Jana-Elst/passionProject/blog/src/content/blog/20251212-1-concept.md

---
title: '#2 Concept'
description: 'Let two strangers talk for just two minutes.'
pubDate: 'Jan 4 2026'
heroImage: '../../assets/notes/20260104-concept1.png'
links: 
    - { title: 'Passion Project Research', url: 'https://www.figma.com/board/GRPQDEXH0DziOyojPpeU3K/Passion-project?node-id=0-1&t=wNoFfJWDigMh43Gp-1' }
    - { title: 'Concept Pitch', url: 'https://www.figma.com/slides/nmPEOl1ZZNPz9g4mxP1xrw/Pitch-passion-project?node-id=1-42&t=YsAiy9dJiDsgLmYT-1' }
---
From my research question: *'How might we use obsolete technologies to break the smartphone bubble and facilitate meaningful micro-interactions between strangers?'*, I created a concept called: *[DIS]CONNECT*.

I want to build an installation for an exhibition or a museum, so the target audience will be broad: from young digital natives to older generations who remember a time before the screen.

My goal for the project is really simple: *'let two strangers talk for just two minutes.'*

## Storyboard
So, what will this look like? I will create an installation split into two different spaces within the exhibition.

In Room A, we have 'The Switchboard'. It will refer to the vintage manual telephone exchange. The kind with cables and plugs. The user here is the Operator. They see jacks labeled not with names, but with themes. To start, the Operator physically plugs the cable of the telephone into the topic of their choice.

At that exact moment, in Room B, a lonely, old-fashioned telephone starts to ring. A random visitor, the Receiver, hears it. Hopefully, curiosity takes over, and they pick up.

And a warm voice-over connects them. It tells the Operator: ‘Ooh, you chose a nice question, I'll let the phone ring on the other end of the line, please wait a moment.’ It tells the Receiver: ‘Thanks for picking up! There's someone on the other end of the line waiting for you.' And for both, the voice-over will state the chosen question.

For the next two minutes, two strangers share a small, unrecorded moment. If there is a long silence, or the time is up, the Voice Over gently intervenes to end the call.

<div class="note">
I will switch from the switchboard to the rotary dial of the telephone. By doing this, the interaction will be more user-friendly.
</div>

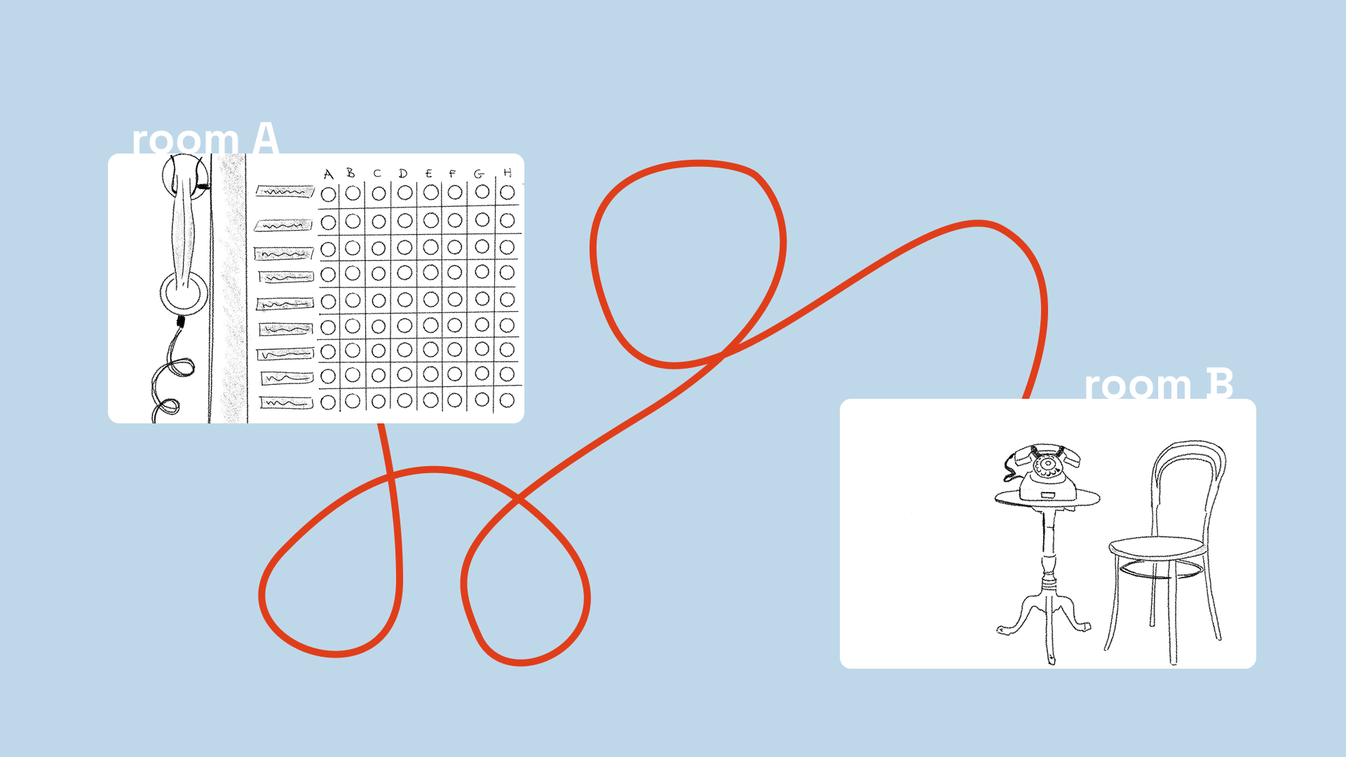
[picture p1: blog/src/assets/notes/20260104-concept1.png]

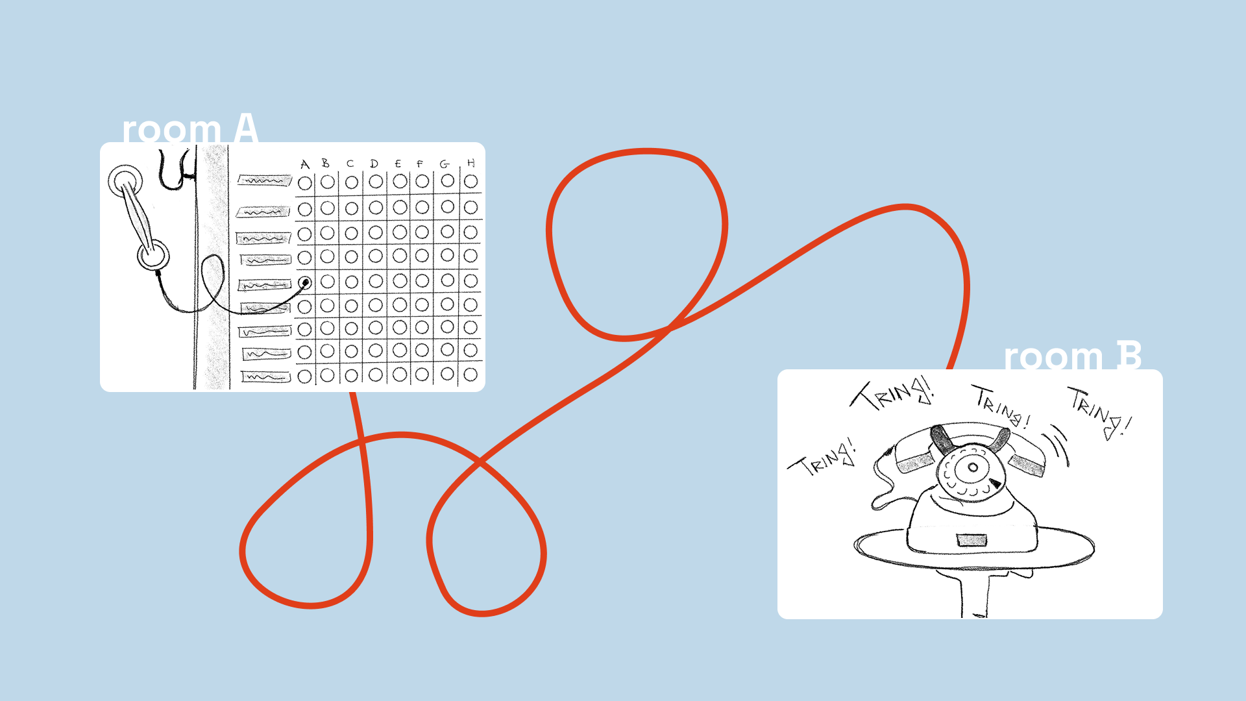
[picture p2: blog/src/assets/notes/20260104-concept3.png]

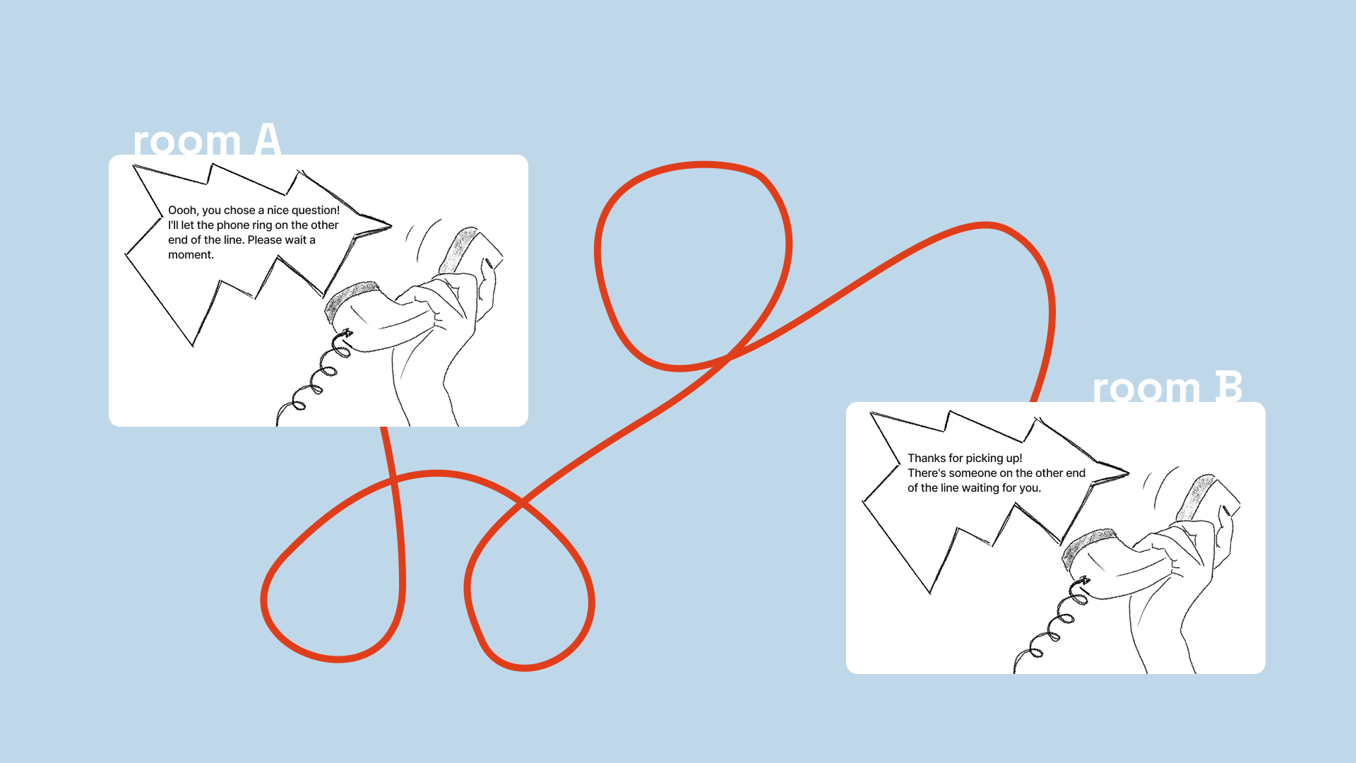
[picture p3: blog/src/assets/notes/20260104-concept4.png]

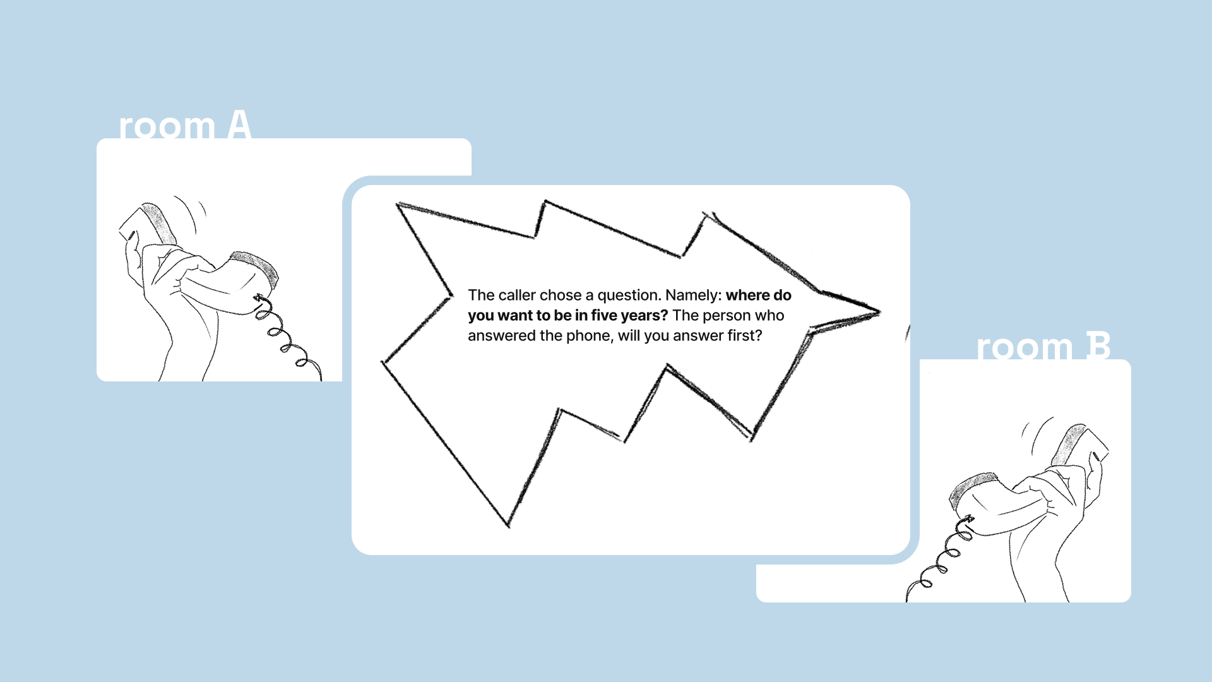
[picture p4: blog/src/assets/notes/20260104-concept5.png]

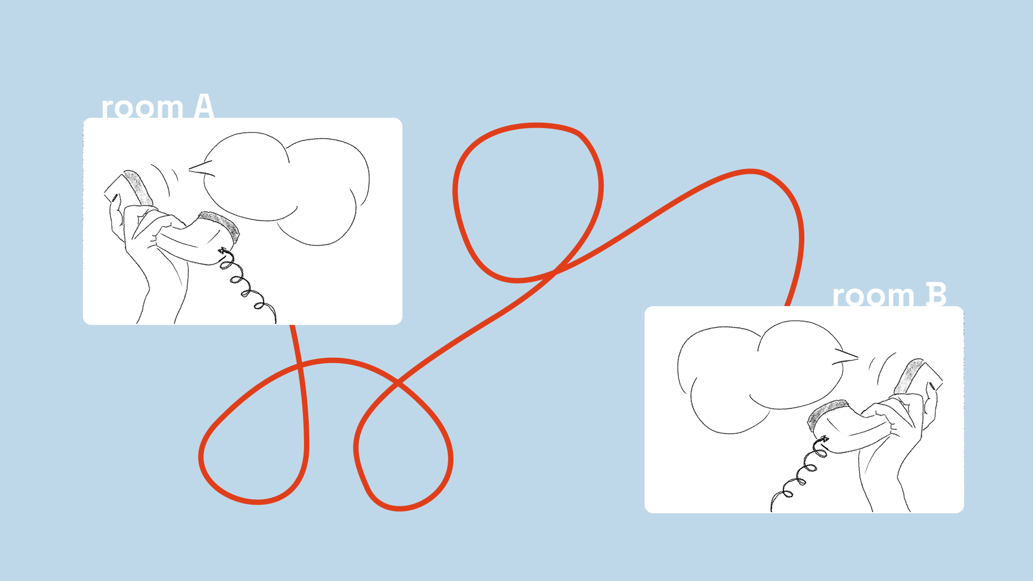
[picture p5: blog/src/assets/notes/20260104-concept6.png]

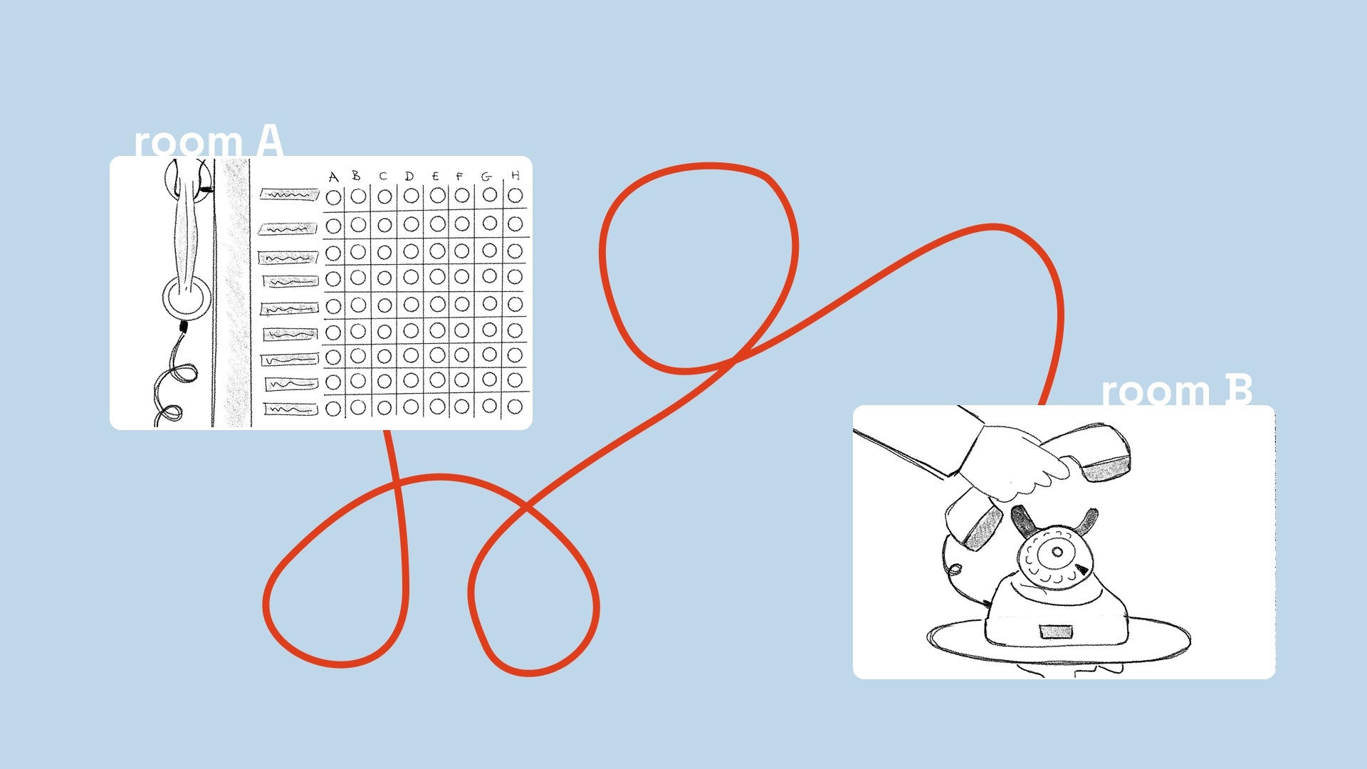
[picture p6: blog/src/assets/notes/20260104-concept7.png]
