Jana-Elst/passionProject/blog/src/content/blog/20260107-electrical-schemes.md

---
title: '#5 Making simulations'
description: |
  Fried an arduino and a lot of capacitors...
  (in the virtual world)
pubDate: 'Jan 7 2026'
heroImage: '../../assets/notes/20260107-no-connection-between-phones.png'
sources:

gemini: 

components: 
  - ThinkerCad

links: 
    - { title: 'sound loop, no connection between phones', url: 'https://www.tinkercad.com/things/2BNsrL1ljib-sound-loops-arduino-no-connection-between-phones' }
    - { title: 'sound loop, connection between phones', url: 'https://www.tinkercad.com/things/3fBIcnZGZkq-copy-of-sound-loops-arduino-connection-between-phones' } 
    - { title: 'sound loop, connection between phones and bell', url: 'https://www.tinkercad.com/things/3fBIcnZGZkq-copy-of-sound-loops-arduino-connection-between-phones' }
---

I managed to fry an Arduino and a handful of capacitors... all because a resistor was actually 0Ω instead of the 300Ω I needed.

But hey, the day wasn't a total loss! By the end, I had:

A simulation where an Arduino feeds different sounds into my two telephones.

A simulation combining the audio circuit and the direct-talk circuit, regulated by a relay.

I also tried to simulate the bells, but that failed for now. I’ll have to give that another shot later!

## Sound loop, no connection between phones

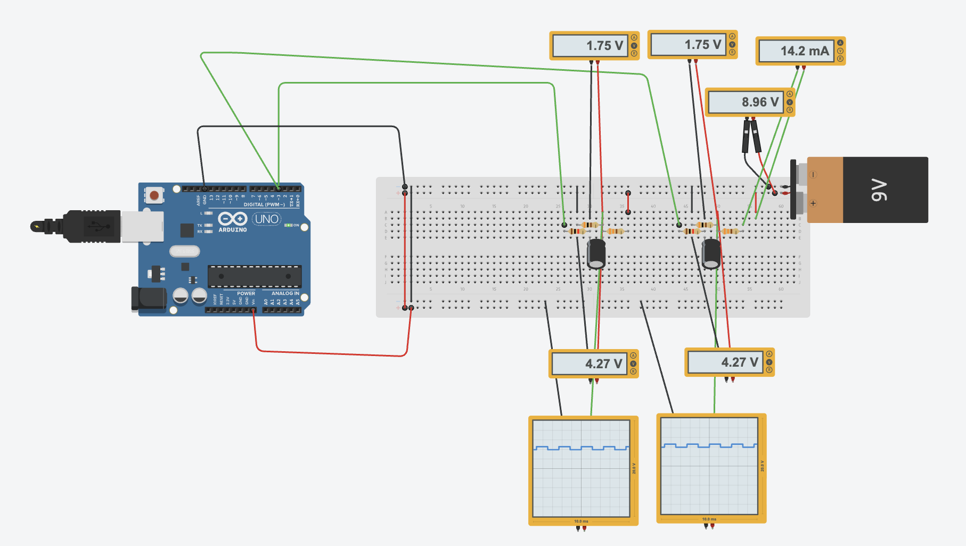
[picture p17: blog/src/assets/notes/20260107-no-connection-between-phones.png]


This circuit consists of an Arduino, the telephone (represented as a resistor of 0.3kΩ), a capacitor, and 2 resistors (one of 330𝛺 and one of 1k𝛺). The 1k𝛺 resistor is used to limit the current to the Arduino, and the 330𝛺 resistor is used to set the volume. Picking a higher value resistor will result in a lower volume.
The capacitor acts like a sort of wall. It blocks DC current but allows AC current (which creates the sound) to pass.

<a href="https://www.tinkercad.com/things/2BNsrL1ljib-sound-loops-arduino-no-connection-between-phones" target="_blank">Find the simulation here -></a>

## Sound loop, connection between phones
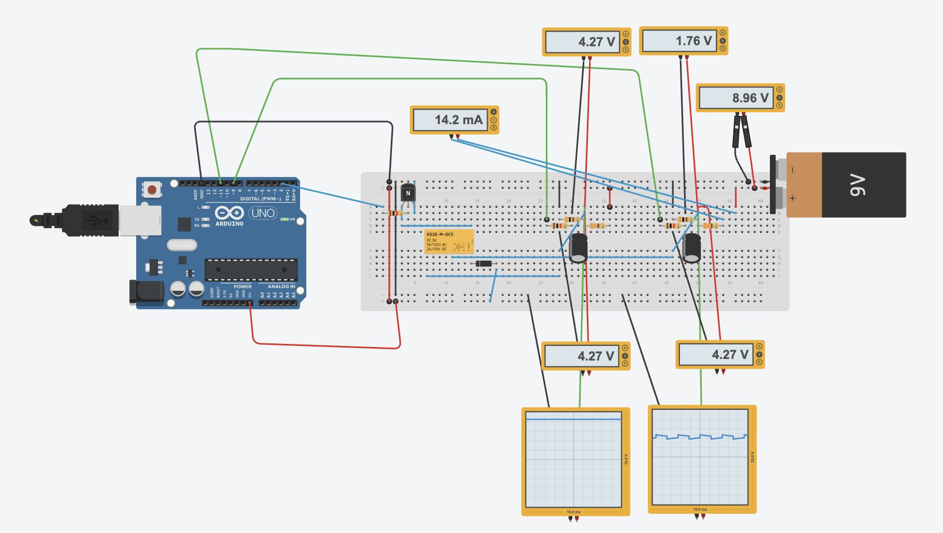
[picture p18: blog/src/assets/notes/20260107-connection-between-phones.png]


To connect the two phones and allow the Arduino's audio to pass through, I added a relay to merge the sound loop with the intercom circuit.

<a href="https://www.tinkercad.com/things/3fBIcnZGZkq-copy-of-sound-loops-arduino-connection-between-phones" target="_blank">Find the simulation here -></a>
