Jana-Elst/passionProject/blog/src/content/blog/20260110-music.mdx

---
title: '#8 Playing music'
description: |
  Can I play music from my Arduino into my phone?
  The most satisfying moment of the week!
pubDate: 'Jan 10 2026'
heroImage: '../../assets/20260110-header.png'
sources:

gemini: 

components: 

links: 
---
import twoSeconds from '../../assets/videos/20260110-twoSeconds.mp4?url';
import oneSong from '../../assets/videos/20260110-oneSong.mp4?url';

## The circuit

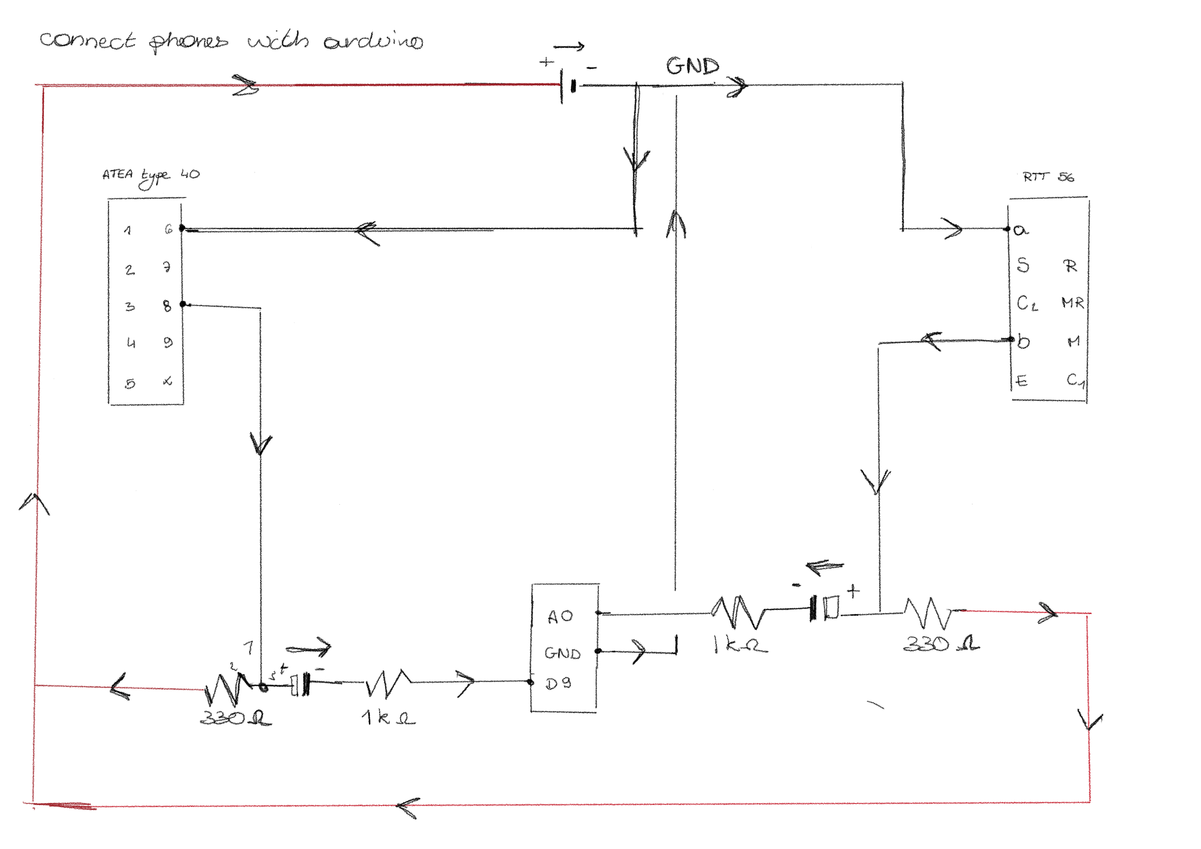
[picture p19: blog/src/assets/notes/20260108-infuse-arduino-sound.png]


## Create a constant tone
The first thing I did was to create a constant tone. This allowed me to check whether the Arduino could send sound signals to the phone. Guess what? It worked!

However, playing a different sound signal on each phone did not work. The library I was using could only play one tone at a time. Something to worry about later!

<a href="https://github.com/Jana-Elst/passionProject/blob/4ee055e18ab01e6d44ad3883bda0e69d9d9342ac/arduinoTests/2026018-1-playTone/2026018-1-playTone.ino" target="_blank" class="link-end">Find the code here -></a>

## Play 2 sec of music
The next step was to play some music instead of just a constant tone. Sadly, an Arduino doesn't have that much memory. So, I could only play 2 seconds of music. To play music, you need to be sure the Arduino can actually read it. So you need to convert it. Therefore, I used "Audacity".

The steps I took:
1. Shorten the music to 2 seconds
2. Export the music with the following settings:
- .wav file
- 8 bit
- 8000 Hz
- Mono
3. From wav to hex <a href="https://notisrac.github.io/FileToCArray/" target="_blank">(using the FileToCArray tool)</a>
4. Add hex into the Arduino code

<a href="https://github.com/Jana-Elst/passionProject/blob/4ee055e18ab01e6d44ad3883bda0e69d9d9342ac/arduinoTests/2026018-2-play3SecSound/20260118-2-play3SecSound/20260118-2-pl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" target="_blank" class="link-end">Find the code here -></a>

<video width="100%" height="600" controls>
  <source src={twoSeconds} />
</video>

## Play 1 song
In the end, I didn't want to be limited to only two seconds of sound. I want to play various voice messages and instructions, so I definitely need more storage than that.

To solve this, I added a micro SD card reader to my Arduino to expand its memory. And now, my phone is playing a whole song!

<a href="https://github.com/Jana-Elst/passionProject/blob/4ee055e18ab01e6d44ad3883bda0e69d9d9342ac/arduinoTests/20260110_1_playMusic1File/20260110_1_playMusic1File.ino" target="_blank" class="link-end">Find the code here -></a>

<video width="100%" height="600" controls>
  <source src={oneSong} />
</video>

## Play a different song on each phone
Now that I can play one song, you'd think playing different songs on each phone would be easy. But it really isn't. Between the Arduino's limitations and the buffering, it’s just not working that well yet. I’ve decided to put the coding on hold for a moment. I want to ensure the hardware is 100% perfect first.

<a href="https://github.com/Jana-Elst/passionProject/blob/4ee055e18ab01e6d44ad3883bda0e69d9d9342ac/arduinoTests/20260110-1-playMusic/20260110-1-playMusic.ino" target="_blank" class="link-end">Find the code here -></a>

<div class="note">
At the moment I was just running tests to see if my hardware setup was working. All of the code is made with Gemini Pro.
</div>
