Jana-Elst/passionProject/blog/src/content/blog/20260113-the-wrong-relays.mdx

---
title: '#9 The wrong relays'
description: |
  There are more types of relays than I thought.
pubDate: 'Jan 13 2026'
heroImage: '../../assets/pictures/20260113-header.webp'
sources:

gemini: 

components: 

links: 
---
import toggleLights from '../../assets/videos/20260113-toggleLights.mp4?url';
import alternateMusic from '../../assets/videos/20260113-alternateMusic.mp4?url';

A few days ago, I put together several simulations [(find them in this post)](../20260107-electrical-schemes). However, I realized I had used the wrong relays in my simulation, or rather, I had bought the wrong ones in real life!

Because of that, I had to design a <a href="https://www.tinkercad.com/things/hHAPCORA5sY-def-talking-sound" target="_blank">new circuit</a> using the correct relays.

To verify that everything works, I added some LEDs. Since I’m using WPM406 relay modules, I don't need to add external transistors or flyback diodes to my physical circuit; they are already built into the modules.

## First test
For the first test, I wanted to confirm the relays were switching correctly. I used LEDs to represent the different states:

**Talking Mode:** If the relays are in their Normally Closed (NC) state, the red LED should light up when both phones are off-hook.

**Music Mode:** If the relays are triggered (Normally Open/NO state), one of the green LEDs should light up, depending on which phone is off-hook.

<div>
<a href="https://github.com/Jana-Elst/passionProject/blob/4ee055e18ab01e6d44ad3883bda0e69d9d9342ac/arduinoTests/20260112-1-testRelays/20260112-1-testRelays.ino" target="_blank">Arduino code -></a>
</div>
<div>
<a href="https://www.tinkercad.com/things/hHAPCORA5sY-def-talking-sound" target="_blank">Simulation circuit -></a>
</div>

<video width="100%" height="600" controls>
  <source src={toggleLights} />
</video>

## Second test
To see if the circuit actually performed under load, I tested it with sound.

**Normally Closed:** In talking mode, the intercom should be active so you can speak between the two phones. I tested this with some friends, and it worked perfectly!

**Normally Open:** In music mode, the Arduino plays audio from the micro SD card.

I initially tried to play two different songs at the same time, but the Arduino couldn't handle it. Instead, I programmed it to play one song and switch the output between the two phones every 5 seconds. This allowed me to verify that both phones were receiving the audio signal correctly.

<a href="https://github.com/Jana-Elst/passionProject/blob/76cabe76a41d5c77681f602b0848094a610dc73e/arduinoTests/20260113_1_relaisPlay2Songs/20260113_1_relaisPlay2Songs.ino" target="_blank">Arduino code -></a>

<video width="100%" height="600" controls>
  <source src={alternateMusic} />
</video>
