Jana-Elst/passionProject/blog/src/content/blog/20260118-buffering-and-bytes.mdx

---
title: '#14 buffering and bytes'
description: |
    Streaming audio from a Raspberry Pi to an Arduino
pubDate: 'Jan 18 2026'
heroImage: ../../assets/pictures/20260118-header.webp
sources:

gemini: 

components: 

links: 
---
import musicSlow from '../../assets/videos/20260118-music-slow.mp4?url';
import musicNormal from '../../assets/videos/20260118-music-normal.mp4?url';

After a successful trial controlling LEDs on an Arduino from my Raspberry Pi, the next logical step was to try sending music. My goal is to use the Raspberry Pi as a central "brain" that stores audio files and streams them to multiple Arduinos. Each Arduino then acts as a signal converter for an old telephone handset. However, I quickly learned that "playing music" is fundamentally different from "switching a pin."

<video width="100%" height="600" controls>
  <source src={musicSlow} />
</video>
<video width="100%" height="600" controls>
  <source src={musicNormal} />
</video>

I also managed to write my Python code in VSCode via SSH on my Raspberry Pi.
