Jana-Elst/passionProject/blog/src/content/blog/20260114-reading-dialed-number.mdx

---
title: '#10 Dial a number'
description: |
    Whether you're spinning the dial or sharing a secret, it's all traveling down the same electrical line.
pubDate: 'Jan 14 2026'
heroImage: ../../assets/pictures/20260114-header.webp
sources:

gemini: 

components: 

links: 
---
import dialNumber from '../../assets/videos/20260114-dial.mp4?url';
import onOffHook from '../../assets/videos/20260114-onOffHook.mp4?url';

## Dial a number
In an old rotary phone, everything relies on electrical signals. Dialing a number is basically sending electrical pulses through the line. For example, if you dial a "5," the phone sends five fast electrical pulses. It works similarly to how sound is sent to the phone, but there is one big difference: the pulses are much stronger than the signals used for sound. Because of this, I just had to find the right point in the circuit to capture these electrical pulses and read them with my Arduino.

<a href="https://github.com/Jana-Elst/passionProject/blob/76cabe76a41d5c77681f602b0848094a610dc73e/arduinoTests/20260114-1-reading-dial/20260114-1-reading-dial.ino" target="_blank">Arduino code -></a>

<video width="100%" height="600" controls>
  <source src={dialNumber} />
</video>
<video width="100%" height="600" controls>
  <source src={onOffHook} />
</video>

## Detecting On/Off Hook
Another thing I really need to detect is whether the phones are on-hook or off-hook. If my Arduino can "see" that, I can play sounds, ring the bells, and switch the relays at the exact right moments.

### 1. How it works
When a phone is on-hook, the circuit is open and the resistance is infinite. When you pick up the phone (off-hook), the circuit closes and the resistance drops to about 300 ohms. The Arduino can measure this by checking the current: if the phone is on-hook, the current is zero.

However, this was harder than I expected. Initially, my phones were connected in one big loop, so I could only detect if the entire circuit was open or closed. If just one phone was on-hook, it broke the connection for everything. To make the logic work, I had to find a way to detect the hook status for each phone independently.

### 2. The Solution
To fix this, I gave each phone its own circuit, but they still need to share audio. I solved this by adding a non-polarized capacitor between them.

Think of this capacitor like a rubber wall:
It blocks the DC current, which allows each phone's circuit to stay independent so the Arduino can read them separately.

At the same time, it allows the AC signals (the sound) to vibrate through the wall, letting the audio pass from one phone to the other.

Sadly, I could only make a simulation of this circuit, since I don't have the right capacitor to build it.

<a href="https://www.tinkercad.com/things/41x8HnYmaoE-talking-sound-measure-onoffhook" target="_blank">Simulation circuit -></a>
