Jana-Elst/passionProject/blog/src/assets/20260110-header.png

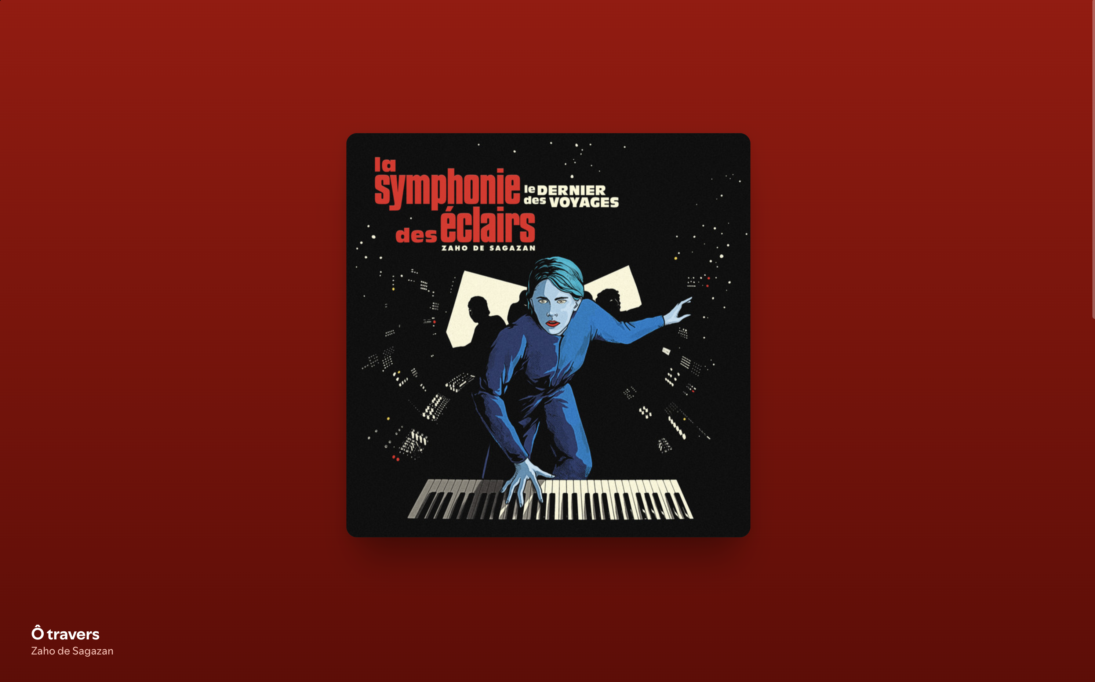
blog/src/assets/20260110-header.png
