Jana-Elst/passionProject/blog/src/assets/20260124-header.jpg

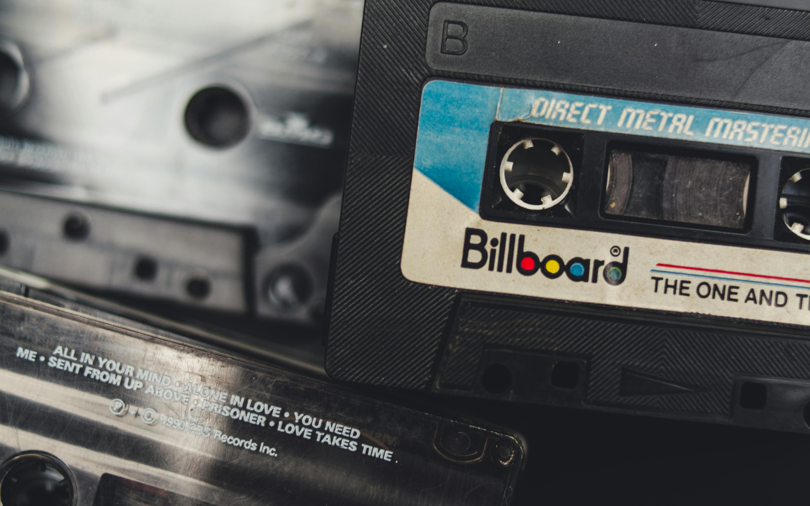
blog/src/assets/20260124-header.jpg
