Jana-Elst/passionProject/blog/src/assets/20260207-header.png

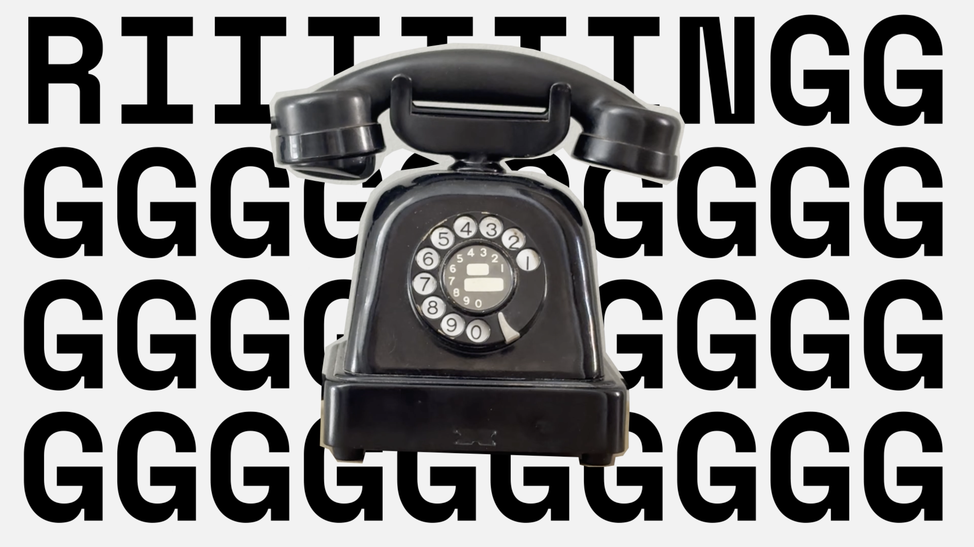
blog/src/assets/20260207-header.png
