Jana-Elst/passionProject/blog/src/assets/20260208-header.png

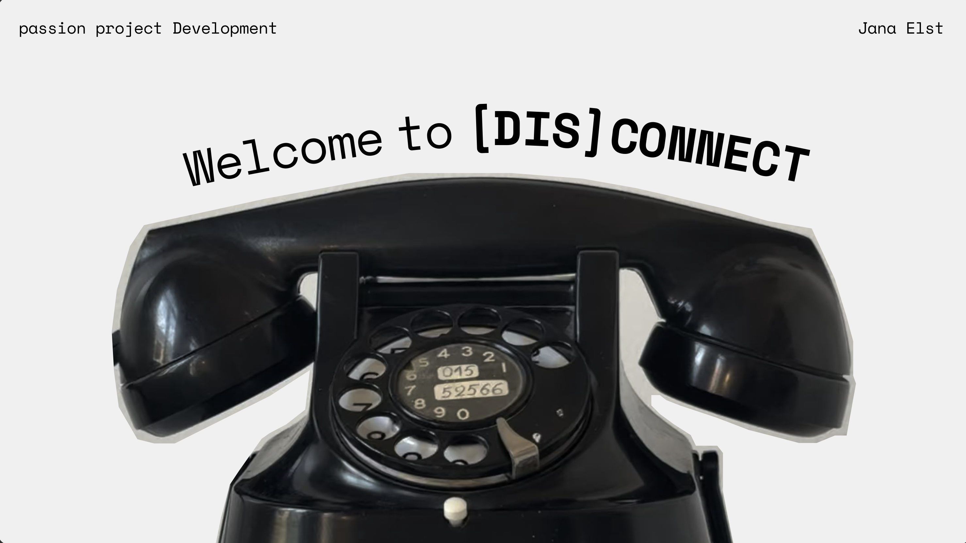
blog/src/assets/20260208-header.png
