Jana-Elst/passionProject/blog/src/assets/notes/20260104-header.png

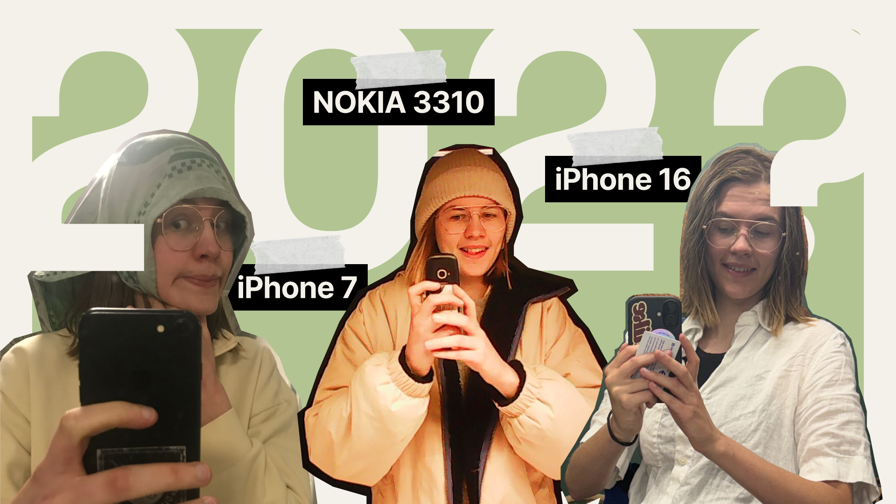
blog/src/assets/notes/20260104-header.png
