Jana-Elst/passionProject/blog/src/assets/pictures/20260105-header.webp

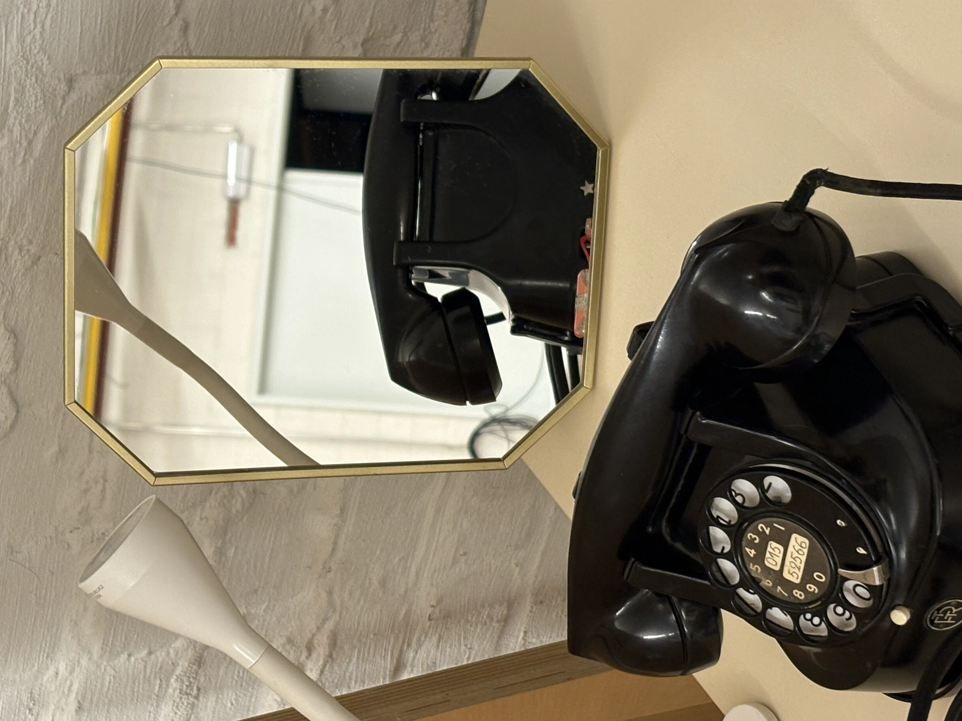
blog/src/assets/pictures/20260105-header.webp
