Jana-Elst/passionProject/blog/src/assets/pictures/20260106-header.webp

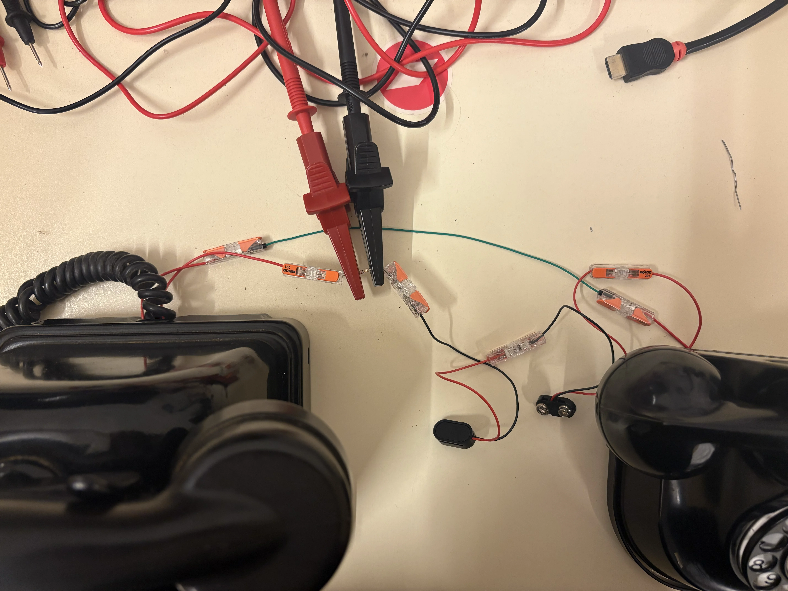
blog/src/assets/pictures/20260106-header.webp
