Jana-Elst/passionProject/blog/src/assets/pictures/20260108-header.webp

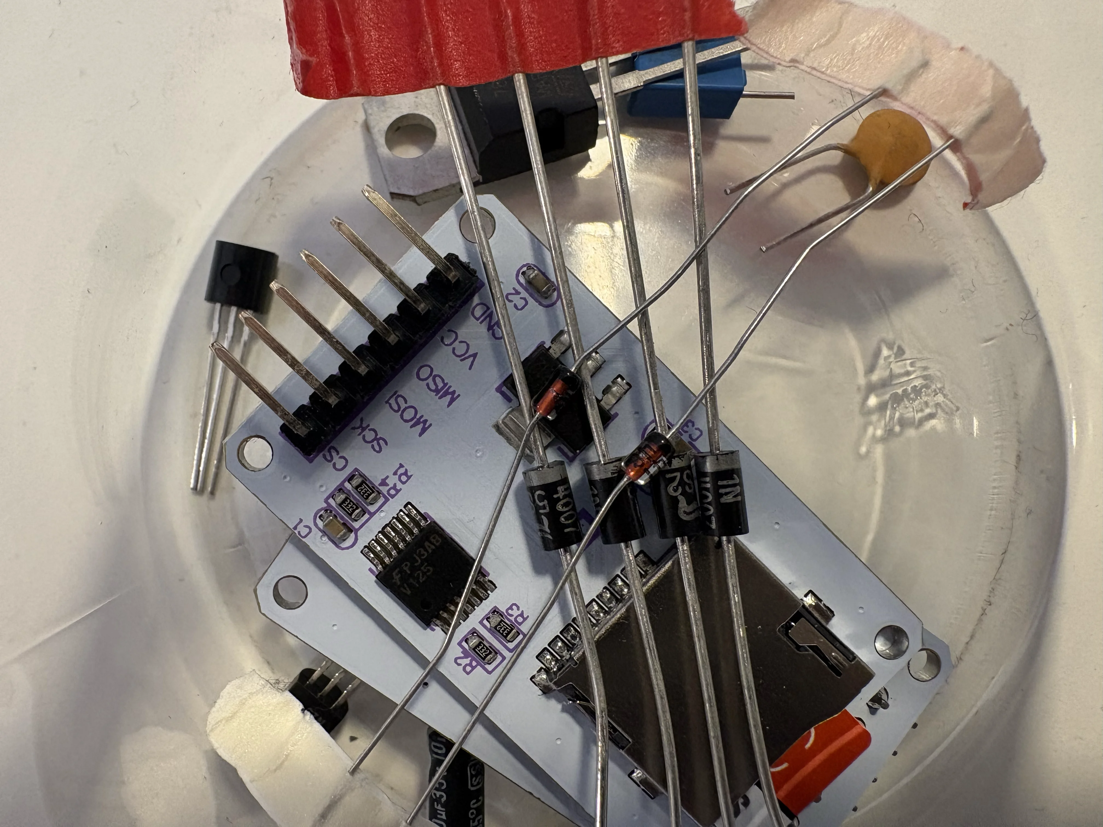
blog/src/assets/pictures/20260108-header.webp
