Jana-Elst/passionProject/blog/src/assets/pictures/20260109-oxidated-wire.webp

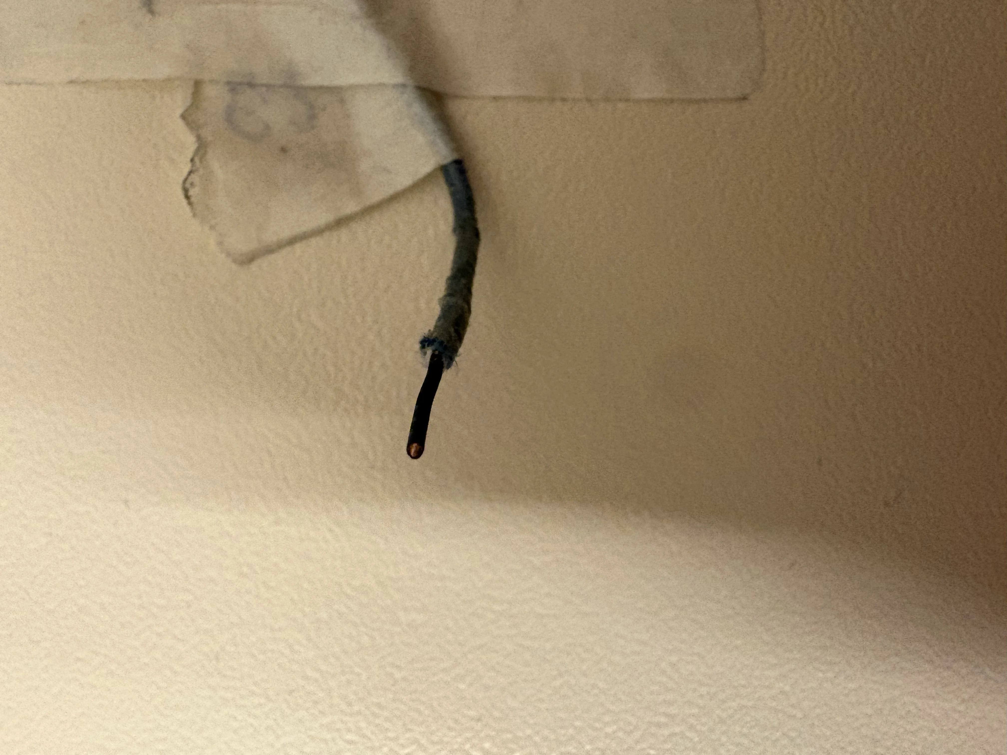
blog/src/assets/pictures/20260109-oxidated-wire.webp
