Jana-Elst/passionProject/blog/src/assets/pictures/20260113-header.webp

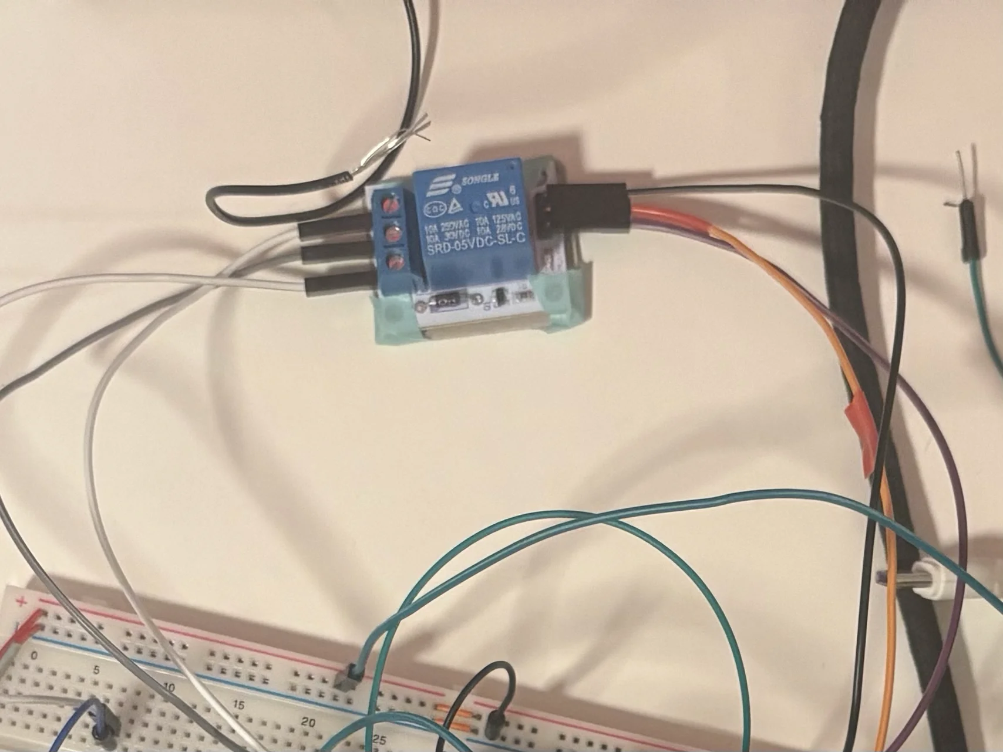
blog/src/assets/pictures/20260113-header.webp
