Jana-Elst/passionProject/blog/src/assets/pictures/20260114-header.webp

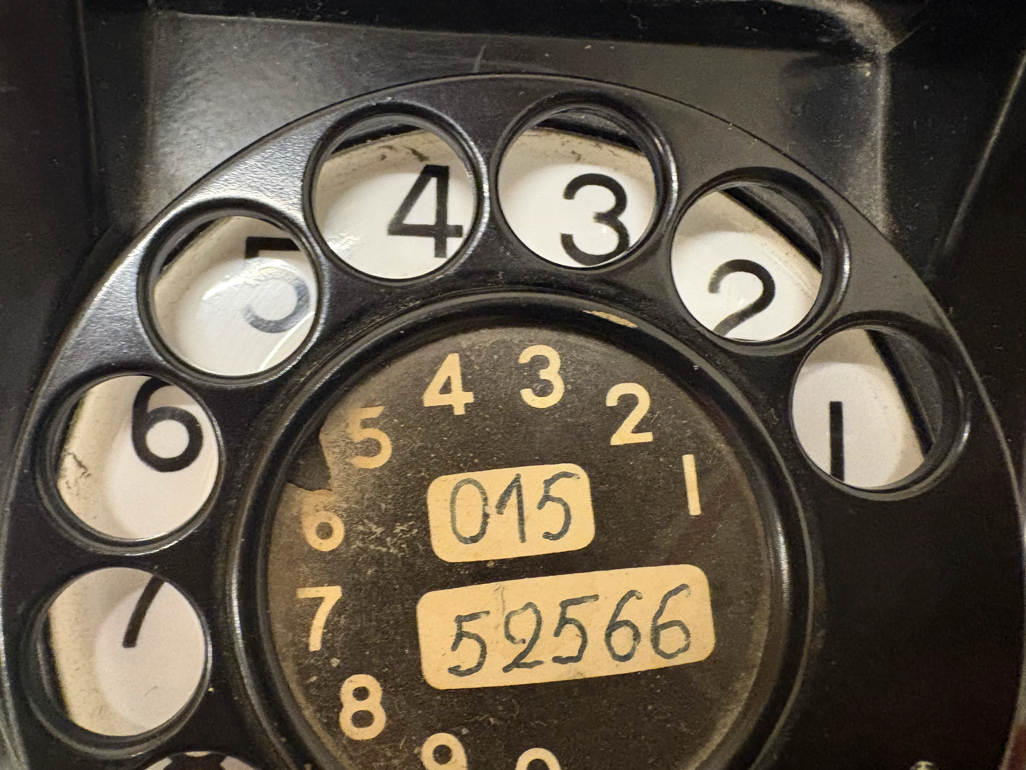
blog/src/assets/pictures/20260114-header.webp
