Jana-Elst/passionProject/blog/src/assets/pictures/20260115-header.webp

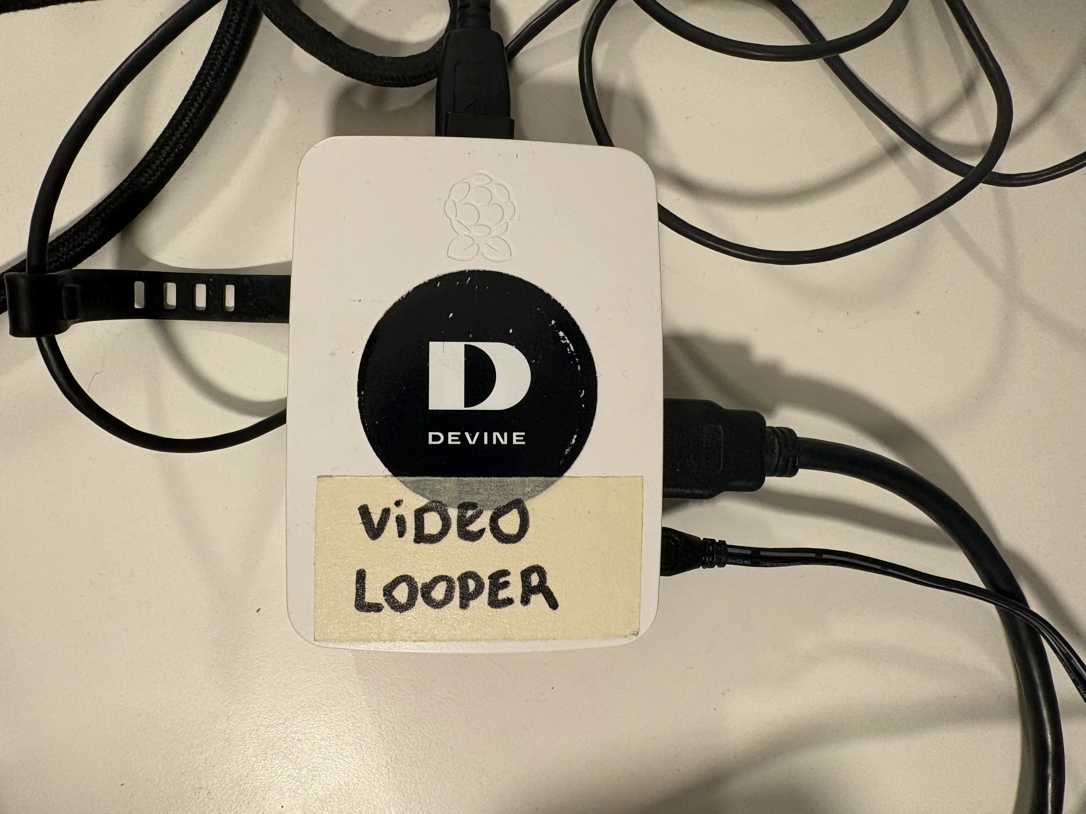
blog/src/assets/pictures/20260115-header.webp
