Jana-Elst/passionProject/blog/src/assets/pictures/20260117-header.webp

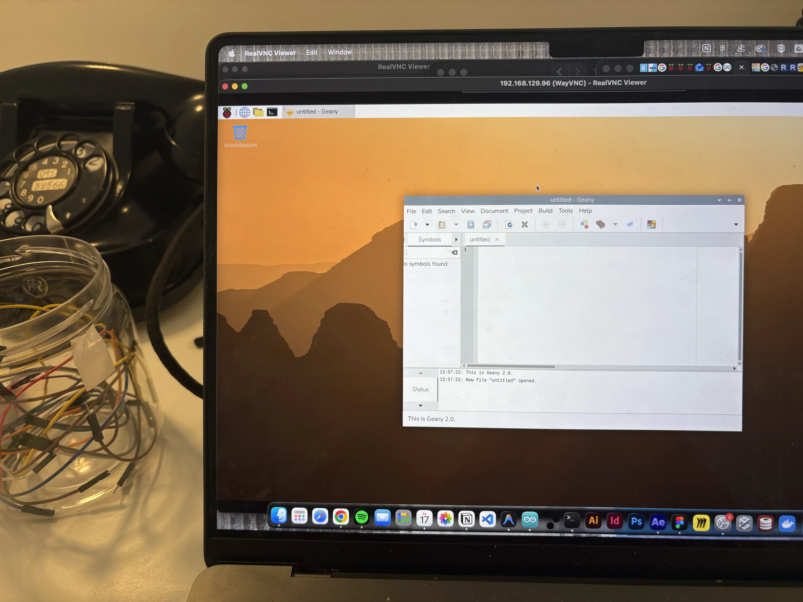
blog/src/assets/pictures/20260117-header.webp
