Jana-Elst/passionProject/blog/src/assets/pictures/20260118-header.webp

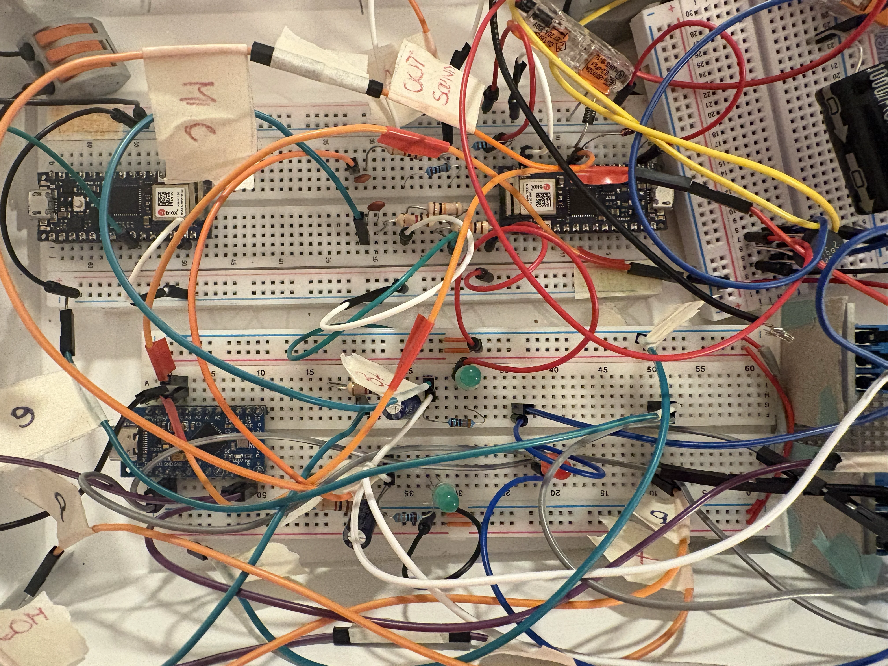
blog/src/assets/pictures/20260118-header.webp
