Jana-Elst/passionProject/blog/src/assets/pictures/20260118-image1.webp

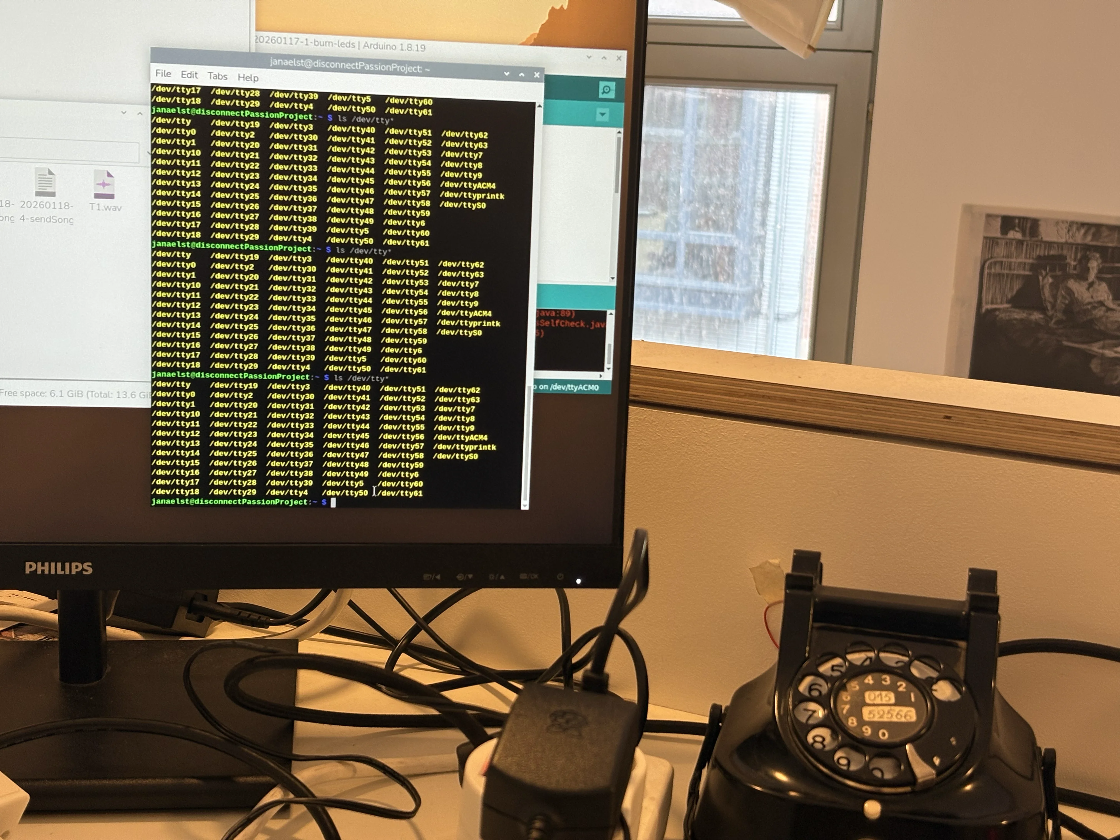
blog/src/assets/pictures/20260118-image1.webp
