Jana-Elst/passionProject/blog/src/assets/pictures/20260121-header.webp

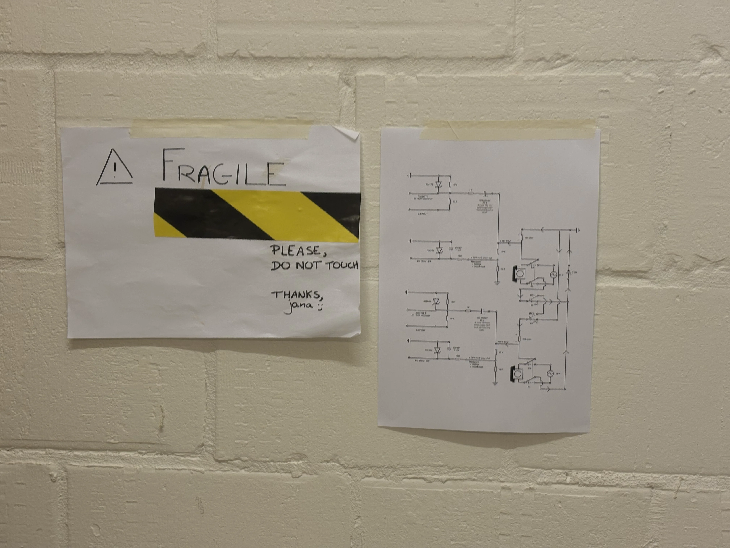
blog/src/assets/pictures/20260121-header.webp
