Jana-Elst/passionProject/blog/src/assets/pictures/20260122-header.webp

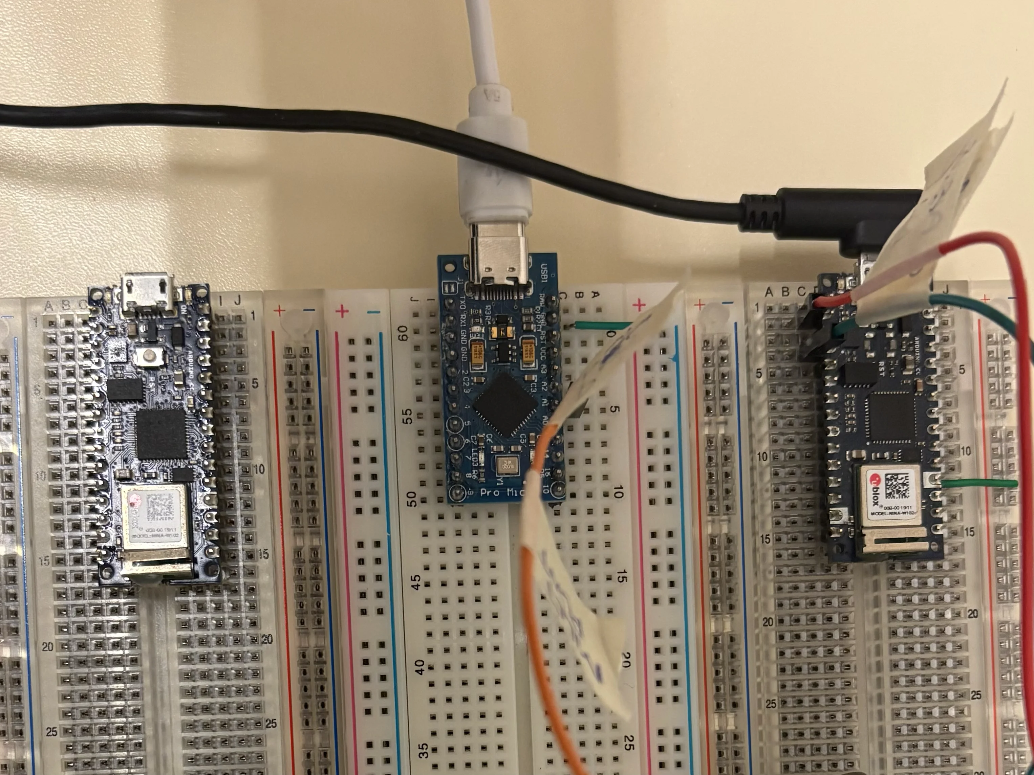
blog/src/assets/pictures/20260122-header.webp
