Jana-Elst/passionProject/blog/src/assets/pictures/20260125-header.webp

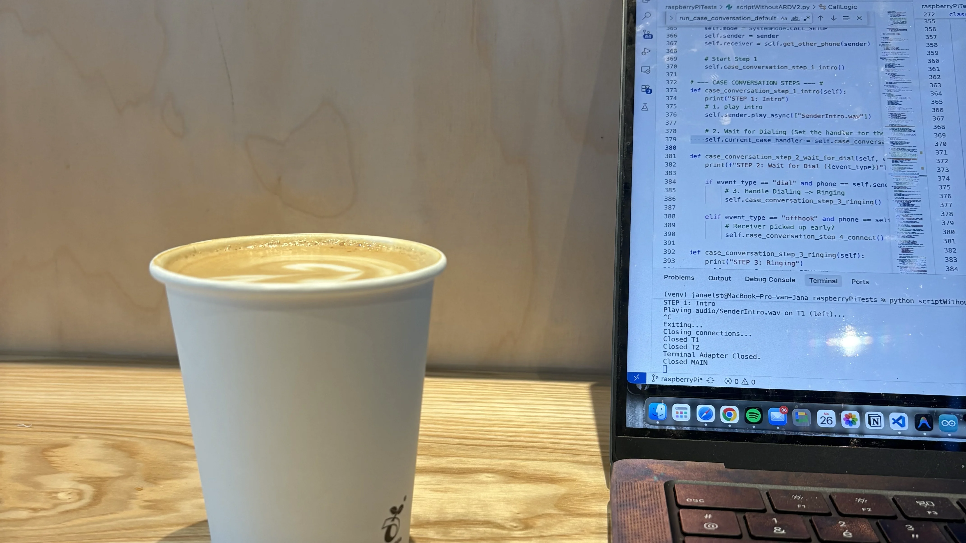
blog/src/assets/pictures/20260125-header.webp
