Jana-Elst/passionProject/blog/src/assets/pictures/20260126-header.jpeg

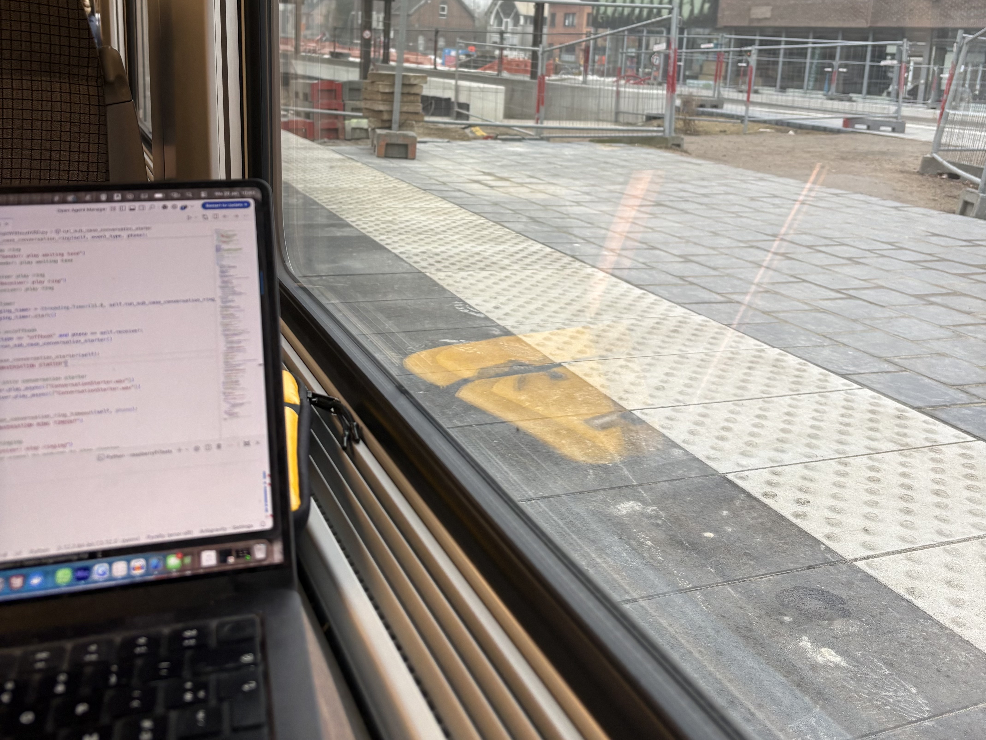
blog/src/assets/pictures/20260126-header.jpeg
