Jana-Elst/passionProject/blog/src/assets/pictures/20260127-header.webp

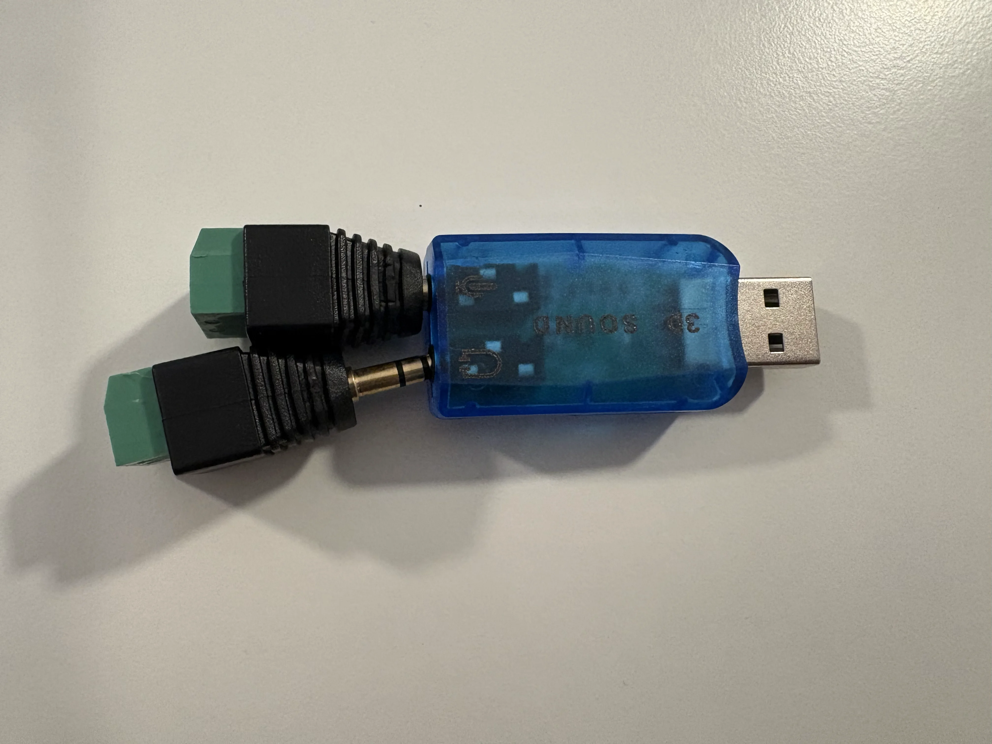
blog/src/assets/pictures/20260127-header.webp
