Jana-Elst/passionProject/blog/src/assets/pictures/20260128-header.webp

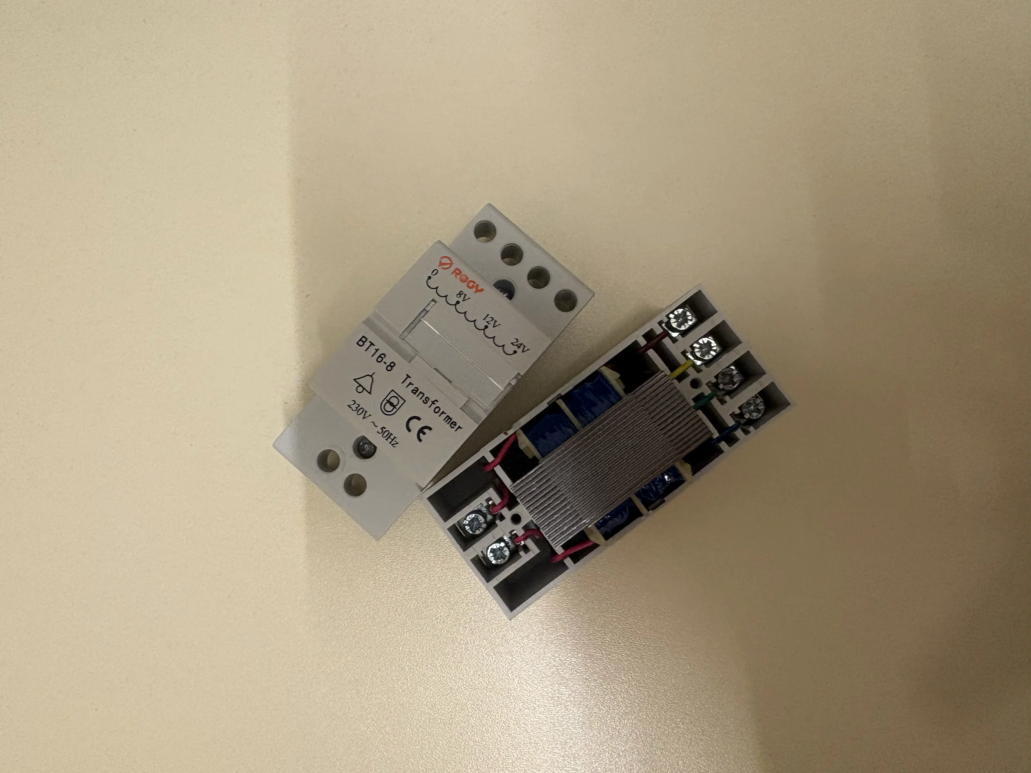
blog/src/assets/pictures/20260128-header.webp
