Jana-Elst/passionProject/blog/src/assets/pictures/20260129-header.webp

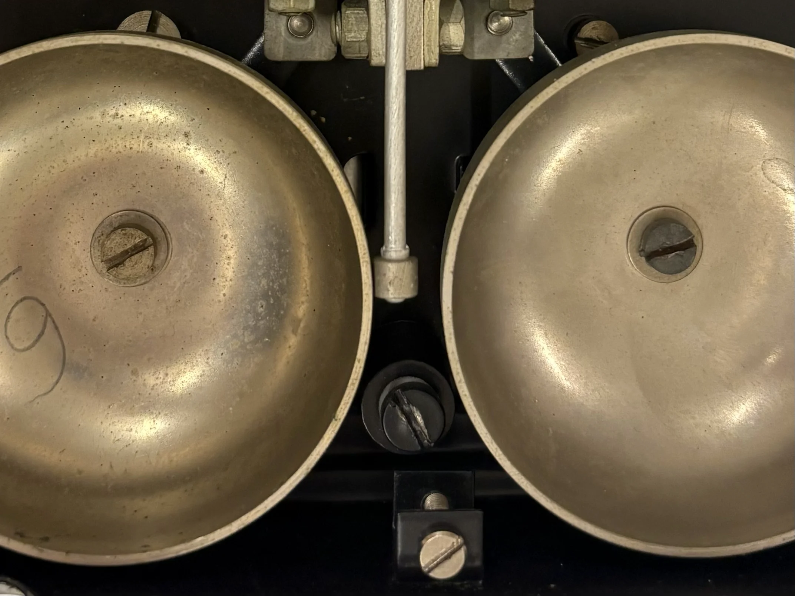
blog/src/assets/pictures/20260129-header.webp
