Jana-Elst/passionProject/blog/src/assets/pictures/20260201-header.webp

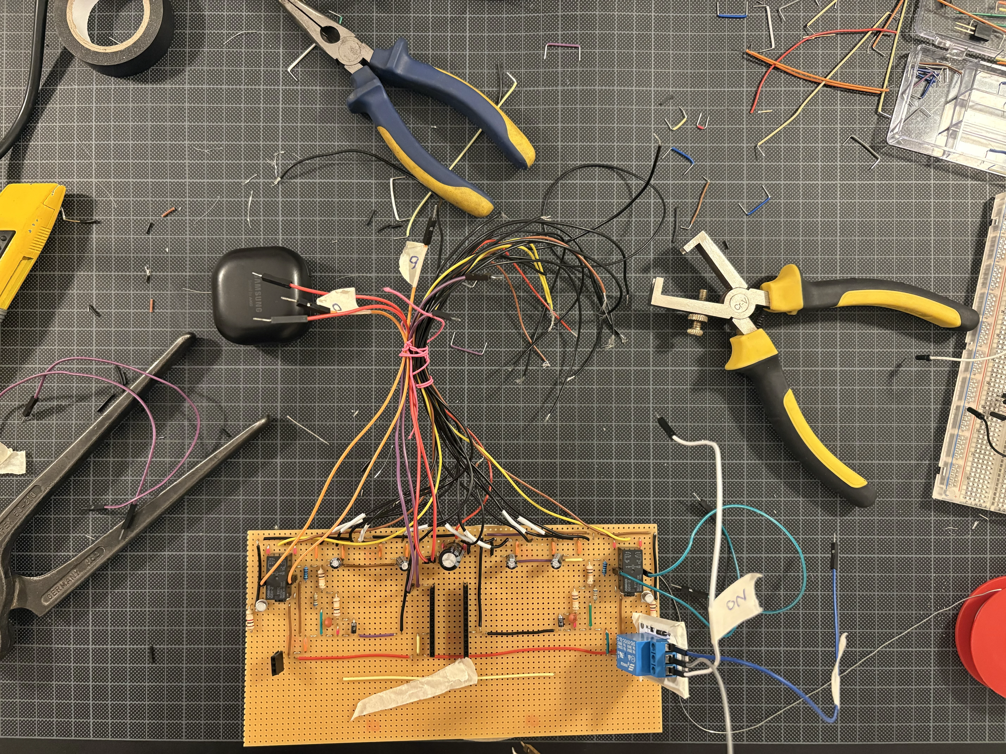
blog/src/assets/pictures/20260201-header.webp
