Jana-Elst/passionProject/blog/src/assets/pictures/20260206-header.png

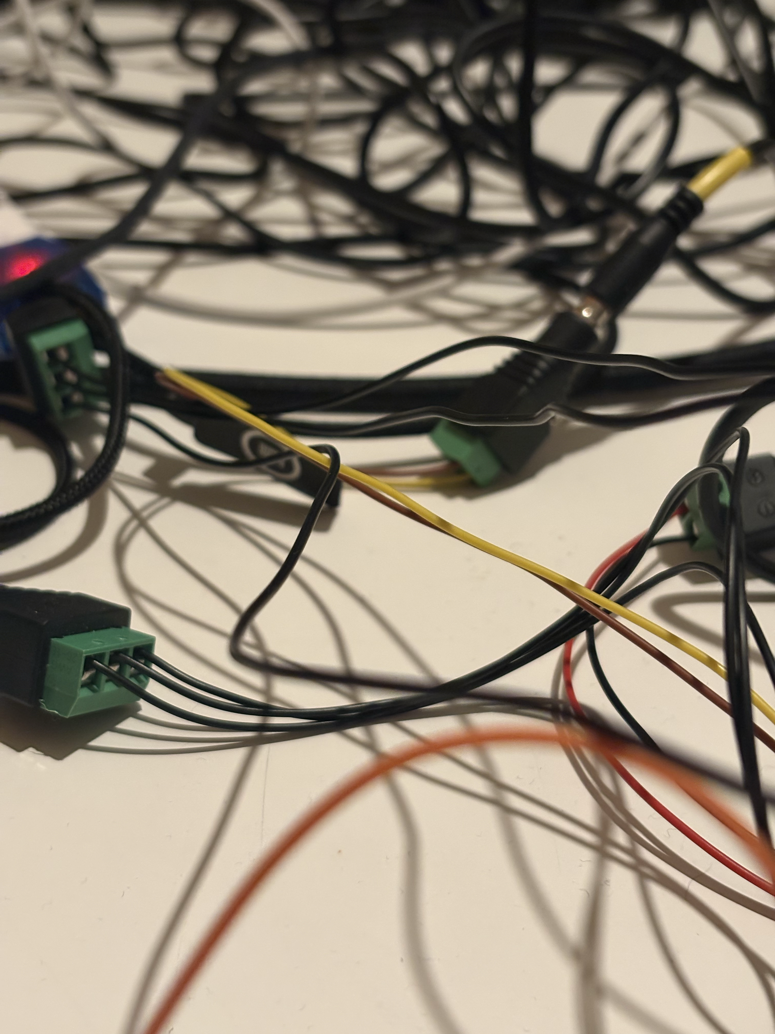
blog/src/assets/pictures/20260206-header.png
