Jana-Elst/passionProject/blog/src/assets/pictures/20260130-soldering-1.png

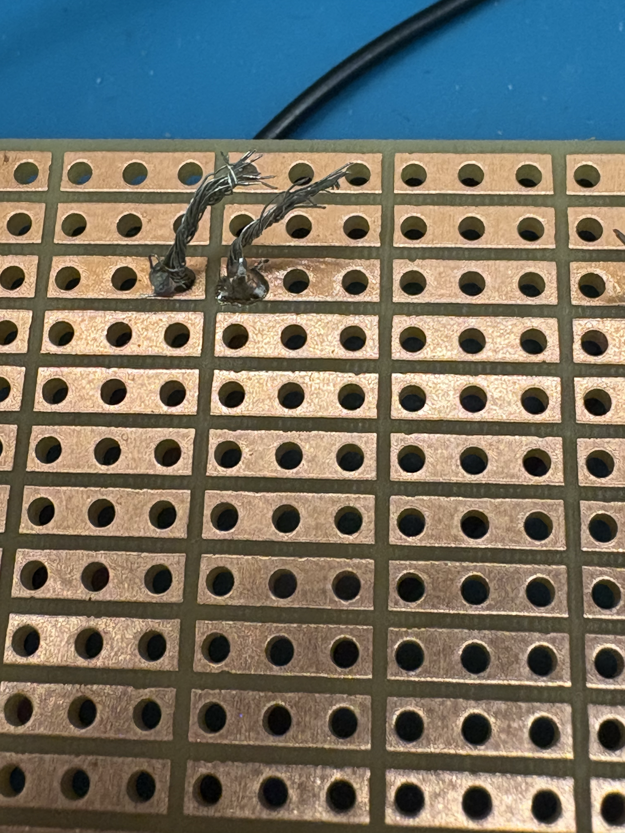
blog/src/assets/pictures/20260130-soldering-1.png
