Jana-Elst/passionProject/testsAndDemos/raspberryPiTests/python_explanations.md

# Python Concepts Explanation

Here are the explanations for the concepts you encountered in the code.

## 1. What does `__X__` mean? (e.g. `__init__`)
In Python, methods starting and ending with double underscores are called **Dunder Methods** (short for "Double UNDERscore"). They are special "magic" methods that Python calls automatically in specific situations.

- **`__init__`**: This is the **constructor**. Python calls it automatically when you create a new instance of a class (e.g., `phone = Phone(...)`). It "initializes" the object.
- Other common examples:
    - `__str__`: Called when you do `str(object)` or `print(object)`.
    - `__len__`: Called when you do `len(object)`.

## 2. Type Hints (`List`, `Tuple`, `Union`, `Optional`)
These tell you (and code editors) what *type* of data a variable holds. They don't change how the code runs, but they prevent bugs.

- **`List[str]`**: A list containing strings. E.g., `["hello", "world"]`.
- **`Tuple[str, float]`**: A fixed-size collection with specific types. E.g., `("PAUSE", 3.5)`. It's like a list but immutable (cannot be changed).
- **`Union[str, int]`**: The value can be EITHER a string OR an integer.
- **`Optional[str]`**: The value can be a string OR `None`. It's short for `Union[str, None]`.
- **`Callable`**: A function passed as a variable (like your `callback` in timers).

**Example in your code:**
```python
def play_async(self, playlist: List[Union[str, Tuple[str, float]]]):
```
This reads: *"playlist is a List where every item is EITHER a string (filename) OR a Tuple containing a string and a float (PAUSE command)."*

## 3. The `_` prefix (e.g. `_play_sequence`)
A single underscore at the start of a name (like `_play_sequence` or `_init_lookup_table`) is a convention meaning **"Internal Use Only"** or **"Private"**.
It tells other programmers: *"This function is a helper for this class. You probably shouldn't call it from outside."*

## 4. `threading.Event()` and Threading
- **`threading.Event()`**: Think of this as a simple traffic light flag that threads can look at.
    - `stop_event.set()`: Turns the flag ON (Red light / Stop).
    - `stop_event.clear()`: Turns the flag OFF (Green light / Go).
    - `stop_event.is_set()`: Checks if the flag is on.
    - We use this so the main program can tell the background audio thread "Please stop playing now!" immediately.

- **`daemon=True`**: This means the thread is a "background helper". If your main program quits (e.g. you press Ctrl+C), these threads will be killed automatically. Without this, your program might hang forever waiting for audio to finish playing.

## 5. `hasattr(dev, 'close')`
`hasattr` means **"Has Attribute"**.
```python
if hasattr(dev, 'close'):
    dev.close()
```
This means: *"Does this device object actually HAVE a function called 'close'? If yes, run it."*
This prevents the program from crashing if we try to close something that isn't closable (like a simple variable).

## 6. The `Optional` Thingy
```python
self.sender: Optional[Phone] = None
```
This means: *"The variable `sender` will hold a `Phone` object, BUT initially it is empty (`None`)."*

## 7. `threading.Timer`
```python
timer = threading.Timer(duration, callback)
timer.start()
```
This creates a separate "countdown clock".
- It runs in the background.
- After `duration` seconds, it automatically calls the function `callback`.
- It does not pause your main code like `time.sleep()` would.
