Jana-Elst/passionProject/testsAndDemos/arduinoTests/2026018-2-play3SecSound/20260118-2-play3SecSound/20260118-2-play3SecSound.ino

#include <avr/pgmspace.h>
#include <avr/interrupt.h>

// Your data array (make sure it is uint8_t)
static const uint8_t sample[] PROGMEM  = {
  0x52, 0x49, 0x46, 0x46, 0xfc, 0x45, 0x00, 0x00, 0x57, 0x41, 0x56, 0x45, 0x66, 0x6d, 0x74, 0x20, 
  0x10, 0x00, 0x00, 0x00, 0x01, 0x00, 0x01, 0x00, 0x40, 0x1f, 0x00, 0x00, 0x40, 0x1f, 0x00, 0x00, 
  0x01, 0x00, 0x08, 0x00, 0x64, 0x61, 0x74, 0x61, 0x77, 0x43, 0x00, 0x00, 0x6f, 0x60, 0x65, 0x64, 
  0x66, 0x60, 0x5f, 0x5b, 0x5d, 0x5d, 0x5c, 0x5e, 0x5f, 0x5b, 0x59, 0x5b, 0x5d, 0x5d, 0x58, 0x59, 
  0x58, 0x5c, 0x5a, 0x5e, 0x5f, 0x5f, 0x5f, 0x5d, 0x5d, 0x5f, 0x5d, 0x60, 0x5d, 0x5f, 0x6a, 0x5c, 
  0x56, 0x5b, 0x64, 0x6b, 0x68, 0x5c, 0x5b, 0x56, 0x63, 0x6a, 0x6d, 0x6f, 0x57, 0x55, 0x68, 0x63, 
  0x62, 0x71, 0x6a, 0x66, 0x69, 0x76, 0x69, 0x64, 0x76, 0x75, 0x72, 0x7b, 0x86, 0x7c, 0x74, 0x7a, 
  0x7a, 0x82, 0x85, 0x86, 0x82, 0x7a, 0x8c, 0x8a, 0x82, 0x94, 0x8b, 0x83, 0x82, 0x90, 0x9a, 0x8f, 
  0x91, 0x8d, 0x92, 0x8e, 0x97, 0x97, 0x98, 0x93, 0x8c, 0x97, 0x9c, 0x9a, 0x8c, 0x98, 0x9b, 0xa7, 
  0xa1, 0x92, 0x90, 0x9b, 0xa3, 0x9d, 0x9d, 0xa1, 0xab, 0x9d, 0xa3, 0xaa, 0xa5, 0x9c, 0x8e, 0x91, 
  0xa9, 0xb5, 0xa7, 0xa6, 0xa3, 0x99, 0x96, 0x97, 0x94, 0xa1, 0xab, 0xa6, 0x9a, 0x9c, 0x9b, 0x9f, 
  0xa4, 0xa1, 0x96, 0x93, 0xa6, 0xa3, 0x9f, 0xa3, 0x9e, 0x98, 0xa1, 0xa4, 0xa3, 0x92, 0x97, 0xa7, 
  0xa6, 0x9c, 0x90, 0x98, 0x9f, 0xa4, 0x9e, 0x8f, 0x86, 0x9a, 0x9f, 0x8b, 0x8e, 0x96, 0x93, 0x97, 
  0x94, 0x8d, 0x87, 0x87, 0x98, 0x99, 0x8d, 0x82, 0x82, 0x85, 0x88, 0x8b, 0x7e, 0x77, 0x81, 0x8e, 
  0x79, 0x74, 0x89, 0x84, 0x84, 0x7b, 0x6d, 0x6f, 0x7a, 0x81, 0x75, 0x6c, 0x6b, 0x76, 0x7c, 0x71, 
  0x73, 0x69, 0x66, 0x75, 0x75, 0x6a, 0x64, 0x6c, 0x75, 0x70, 0x66, 0x58, 0x5e, 0x6f, 0x68, 0x6b, 
  0x5b, 0x54, 0x63, 0x5e, 0x5d, 0x58, 0x5d, 0x62, 0x62, 0x5a, 0x49, 0x5a, 0x64, 0x61, 0x5d, 0x57, 
  0x5c, 0x5d, 0x64, 0x67, 0x62, 0x66, 0x5a, 0x5c, 0x61, 0x59, 0x68, 0x67, 0x5b, 0x5f, 0x69, 0x69, 
  0x6c, 0x6e, 0x62, 0x5e, 0x6c, 0x76, 0x68, 0x63, 0x68, 0x6c, 0x72, 0x6d, 0x68, 0x64, 0x63, 0x6f, 
  0x74, 0x70, 0x77, 0x73, 0x72, 0x76, 0x6e, 0x74, 0x76, 0x73, 0x76, 0x77, 0x75, 0x7a, 0x74, 0x72, 
  0x79, 0x78, 0x85, 0x7b, 0x4e, 0x66, 0x92, 0x8d, 0x80, 0x75, 0x82, 0x7f, 0x6c, 0x73, 0x7a, 0x88, 
  0x91, 0x84, 0x81, 0x83, 0x88, 0x8c, 0x8d, 0x83, 0x85, 0x8b, 0x92, 0x91, 0x8f, 0x8c, 0x94, 0x96, 
  0x91, 0x9a, 0x94, 0x91, 0x98, 0xb5, 0x80, 0x5f, 0x9a, 0xaf, 0xa1, 0x9f, 0x9a, 0x97, 0x8d, 0x8c, 
  0xa8, 0x9e, 0x9c, 0x97, 0x92, 0xa0, 0xa8, 0xa7, 0xae, 0x9d, 0x90, 0x99, 0x9d, 0xa6, 0x9d, 0x99, 
  0xa0, 0xa6, 0xa2, 0x98, 0x9b, 0xa0, 0xad, 0xbb, 0x86, 0x82, 0xbf, 0xbe, 0xa9, 0xa4, 0x94, 0x9b, 
  0x85, 0x7d, 0x94, 0x94, 0x95, 0x7b, 0x75, 0x89, 0xa0, 0x8a, 0x95, 0xa8, 0x99, 0x88, 0x7d, 0x82, 
  0x7b, 0x84, 0x90, 0x92, 0x90, 0x8e, 0x85, 0x8b, 0x98, 0x9a, 0x68, 0x62, 0x97, 0x9e, 0x94, 0x91, 
  0x7f, 0x88, 0x7c, 0x8e, 0xa3, 0x6d, 0x8b, 0x97, 0x76, 0x71, 0x76, 0x82, 0x73, 0x70, 0x7c, 0x76, 
  0x5d, 0x67, 0x7f, 0x7e, 0x7f, 0x62, 0x5c, 0x5f, 0x63, 0x6e, 0x76, 0x4a, 0x40, 0x75, 0x8b, 0x6d, 
  0x5c, 0x9b, 0xa7, 0x65, 0x4f, 0x6b, 0x5a, 0x57, 0x67, 0x6e, 0x5f, 0x68, 0x79, 0x87, 0x85, 0x8c, 
  0x8e, 0x6e, 0x5e, 0x40, 0x40, 0x5f, 0x6c, 0x71, 0x60, 0x6c, 0x6e, 0x3d, 0x73, 0x73, 0x7b, 0x94, 
  0x79, 0x5b, 0x2a, 0x4d, 0x6c, 0x60, 0x45, 0x55, 0x6d, 0x6a, 0x5f, 0x5a, 0x82, 0x86, 0x77, 0x69, 
  0x27, 0x37, 0x70, 0x80, 0x7e, 0x3a, 0x49, 0x8f, 0x89, 0x70, 0x80, 0x9b, 0x92, 0x65, 0x29, 0x4a, 
  0x85, 0x7b, 0x7a, 0x79, 0x84, 0x83, 0x5c, 0x75, 0x8a, 0x9f, 0xa9, 0x85, 0x52, 0x5b, 0x8c, 0xb8, 
  0x8e, 0x4f, 0x99, 0x9e, 0x74, 0x79, 0x9b, 0xbf, 0xbe, 0x88, 0x4c, 0x4c, 0x73, 0xa0, 0xc4, 0x92, 
  0x5a, 0x81, 0x94, 0x84, 0x9e, 0xc2, 0xc7, 0x9f, 0x57, 0x60, 0x84, 0x73, 0xa1, 0xb5, 0x8d, 0x88, 
  0x86, 0x9c, 0x9a, 0xb4, 0xd1, 0xb2, 0x6a, 0x43, 0x71, 0xa1, 0xbb, 0xa5, 0x8c, 0x95, 0x82, 0x9e, 
  0x8f, 0x80, 0xc8, 0xcf, 0x99, 0x6e, 0x5b, 0x89, 0xc9, 0x9c, 0x8f, 0x9e, 0x9a, 0x7c, 0x81, 0x9c, 
  0xc1, 0xc8, 0x8c, 0x62, 0x61, 0x9a, 0xba, 0xac, 0x76, 0x6d, 0x6d, 0x9d, 0xaa, 0xc1, 0xe8, 0xb4, 
  0x88, 0x57, 0x3e, 0x7f, 0xc7, 0x9f, 0x8d, 0xa1, 0x9d, 0x64, 0x49, 0x95, 0xaa, 0x99, 0xa4, 0x8c, 
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
};

volatile uint16_t sample_pos = 44; // Start after 44-byte WAV header
uint16_t sample_len = sizeof(sample);
volatile bool playing = false;

// This function starts the music
void startMusic() {
  sample_pos = 44; // Skip the WAV header
  playing = true;
  
  // Set up Pin 9 (OC1A) for PWM
  pinMode(9, OUTPUT);
  
  // Timer 1: Fast PWM, 8-bit, no prescaler (62.5kHz PWM frequency)
  TCCR1A = _BV(COM1A1) | _BV(WGM10);
  TCCR1B = _BV(WGM12) | _BV(CS10);
  
  // Timer 3: Used to trigger the 8000Hz sample rate
  // 16MHz / 8000 = 2000 ticks
  TCCR3A = 0;
  TCCR3B = _BV(WGM32) | _BV(CS30);
  OCR3A = 2000; 
  TIMSK3 = _BV(OCIE3A); // Enable interrupt
  
  sei(); // Enable global interrupts
}

// This runs 8000 times per second to update the sound
ISR(TIMER3_COMPA_vect) {
  if (playing) {
    if (sample_pos < sample_len) {
      uint8_t raw = pgm_read_byte(&(sample[sample_pos++]));
      
      // BOOST ATTEMPT: Shift the audio signal
      // We subtract 128 (center it), multiply by 2 (boost), then add 128 back.
      int16_t boosted = ((int16_t)raw - 128) * 2 + 128;
      
      // Constrain to make sure we don't exceed 0-255
      if (boosted > 255) boosted = 255;
      if (boosted < 0) boosted = 0;
      
      OCR1A = boosted;
    } else {
      playing = false;
    }
  }
}

void setup() {
  startMusic();
}

void loop() {
  // Loop like a ringtone
  if (!playing) {
    startMusic();
  }
}
