Jana-Elst/passionProject/testsAndDemos/raspberryPiTests/scriptWithPI.py

#------------------------ dialing tones, ring tones, etc. from all over the world ------------------------#
# https://www.youtube.com/@TonsOfTONZ/videos

#------------------------ convert files to wav ------------------------#
# brew install ffmpeg
# whole folder -> for f in *.m4a; do ffmpeg -i "$f" -ar 8000 -ac 1 -c:a pcm_u8 "${f%.m4a}.wav"; done
# one file -> ffmpeg -i "input.m4a" -ar 8000 -ac 1 -acodec pcm_u8 "output.wav"
# check if convertion is right -> ffprobe output_filename.wav

#------------------------ IMPORTS ------------------------#
import serial
import serial.tools.list_ports
import pyaudio
import time
import wave
import re
import threading
import sys
import select
import os
import shutil
from pathlib import Path
import struct
import math
from typing import Dict, List, Optional, Tuple, Union, Any, Callable

#------------------------ CONFIG/CONSTANTS ------------------------#
class PhoneState:
    """Enumeration of individual Phone states."""
    IDLE = "IDLE"
    OFFHOOK = "OFFHOOK"          # Just picked up, intro playing
    DIALING = "DIALING"          # Waiting for or entered number
    RINGING = "RINGING"          # Waiting for other to answer
    CONNECTED = "CONNECTED"      # Conversation active
    VOICEMAIL_INTRO = "VOICEMAIL_INTRO"
    VOICEMAIL_RECORDING = "VOICEMAIL_RECORDING"

class SystemMode:
    """Enumeration of the overall System logic mode."""
    IDLE = "IDLE"
    CALL_SETUP = "CALL_SETUP"    # One phone offhook, setting up
    RINGING = "RINGING"          # Waiting for pickup
    CONVERSATION = "CONVERSATION"
    VOICEMAIL = "VOICEMAIL"
    VOICEMAIL_RECORDING = "VOICEMAIL_RECORDING"

AUDIO_DIR = "audio"
DEFAULT_BAUDRATE = 1000000
DIAL_TIMEOUT = 1.0  # seconds

#------------------------ HARDWARE ABSTRACTION ------------------------#
class TerminalAdapter:
    """Simulates a helper Arduino for testing via Terminal input/output."""
    def __init__(self):
        self.name = "TERMINAL"
        print("\n--- TERMINAL INPUT MODE ENABLED ---")
        print("Type commands directly (e.g. T1_OFFH, T1_N1, T2_OFFH)")
    
    def write(self, data: Union[bytes, str]):
        # Simulate sending data to Arduino
        try:
             text = data if isinstance(data, str) else data.decode('utf-8').strip()
             print(f"[TO ARDUINO]: {text}")
        except Exception:
             print(f"[TO ARDUINO]: {data}")
        
    def close(self):
        print("Terminal Adapter Closed.")
    
    @property
    def in_waiting(self) -> int:
        # Non-blocking check for input
        dr, _, _ = select.select([sys.stdin], [], [], 0)
        return len(dr)

    def readline(self) -> bytes:
        # Read from stdin
        line = sys.stdin.readline()
        return line.encode('utf-8')

class MockSerial:
    """A minimal mock for serial devices that are not the MAIN controller."""
    def __init__(self, name: str):
        self.name = name
        self.is_open = True
    
    def write(self, data: Any):
        pass
        
    def close(self):
        self.is_open = False
        print(f"Mock Device {self.name} connection closed.")
    
    @property
    def in_waiting(self) -> int:
        return 0

class AudioChannel:
    """Base interface for Audio Channels."""
    def __init__(self, name: str):
        self.name = name
    
    def play(self, filename: str, stop_event: threading.Event):
        raise NotImplementedError
        
    def record(self, filename: str, stop_event: threading.Event):
        # Default fallback: No recording or not supported on Serial yet
        print(f"Warning: Recording not implemented for {self.name} ({type(self).__name__})")
        return

    def close(self):
        pass

class LocalAudioChannel(AudioChannel):
    """Handles audio playback and recording via PyAudio (Local Sound Card)."""
    def __init__(self, name: str, channel_side: str):
        super().__init__(name)
        self.channel_side = channel_side # 'left' or 'right'
        self.p = pyaudio.PyAudio()
        
        # Pre-compute lookup table for 8-bit unsigned -> 16-bit signed stereo conversion
        self._init_lookup_table()

    def _init_lookup_table(self):
        """Pre-calculates byte conversions to avoid lag during playback."""
        self.lookup_table = [b""] * 256
        for i in range(256):
            # Convert 0..255 (8-bit) to -32768..32767 (16-bit signed)
            sample_val = (i - 128) * 256
            sample_bytes = sample_val.to_bytes(2, byteorder='little', signed=True)
            silence_bytes = (0).to_bytes(2, byteorder='little', signed=True)
            
            if self.channel_side == 'left':
                self.lookup_table[i] = sample_bytes + silence_bytes
            else:
                self.lookup_table[i] = silence_bytes + sample_bytes

    def play(self, filename: str, stop_event: threading.Event):
        """Plays a mono wav file on the specific stereo channel."""
        try:
            with wave.open(str(filename), 'rb') as wf:
                if wf.getnchannels() != 1: 
                    print(f"Error: {filename} must be Mono.")
                    return
                
                width = wf.getsampwidth()
                if width not in [1, 2]:
                     print(f"Error: {filename} must be 8-bit or 16-bit.")
                     return

                stream = self.p.open(format=pyaudio.paInt16,
                                     channels=2,
                                     rate=wf.getframerate(),
                                     output=True)
                
                print(f"Playing {filename} on {self.name} (Local - {self.channel_side})...")
                
                chunk_size = 4096 
                data = wf.readframes(chunk_size)
                
                while data and not stop_event.is_set():
                    output_bytes = b""
                    
                    if width == 1:
                        # 8-bit -> Use lookup table
                        output_bytes = b"".join(self.lookup_table[b] for b in data)
                    else:
                        # 16-bit -> Unpack and interleave with silence
                        count = len(data) // 2
                        shorts = struct.unpack(f"<{count}h", data)
                        
                        stereo_data = bytearray()
                        silence_bytes = b'\x00\x00'
                        
                        for sample in shorts:
                            sample_bytes = sample.to_bytes(2, byteorder='little', signed=True)
                            if self.channel_side == 'left':
                                stereo_data.extend(sample_bytes + silence_bytes)
                            else:
                                stereo_data.extend(silence_bytes + sample_bytes)
                        
                        output_bytes = bytes(stereo_data)

                    stream.write(output_bytes)
                    data = wf.readframes(chunk_size)
                
                stream.stop_stream()
                stream.close()

        except Exception as e:
            print(f"Error playing audio on {self.name}: {e}")

    def record(self, filename: str, stop_event: threading.Event):
        """Records audio from default input to a wav file."""
        try:
            chunk = 1024
            fmt = pyaudio.paInt16
            channels = 1
            rate = 8000
            
            stream = self.p.open(format=fmt,
                                 channels=channels,
                                 rate=rate,
                                 input=True,
                                 frames_per_buffer=chunk)
                                 
            print(f"Recording to {filename} on {self.name}...")
            frames = []
            
            while not stop_event.is_set():
                data = stream.read(chunk, exception_on_overflow=False)
                frames.append(data)
                
            print(f"Recording Finished. Saving {filename}...")
            
            stream.stop_stream()
            stream.close()
            
            path = f"{AUDIO_DIR}/{filename}"
            with wave.open(path, 'wb') as wf:
                wf.setnchannels(channels)
                wf.setsampwidth(self.p.get_sample_size(fmt))
                wf.setframerate(rate)
                wf.writeframes(b''.join(frames))
                
        except Exception as e:
            print(f"Error recording on {self.name}: {e}")

    def close(self):
        self.p.terminate()

class SerialAudioChannel(AudioChannel):
    """Streams audio raw bytes to a connected Arduino via Serial."""
    def __init__(self, name: str, serial_port: serial.Serial):
        super().__init__(name)
        self.ser = serial_port
        self.chunk_size = 64 # Match Arduino code
        
    def play(self, filename: str, stop_event: threading.Event):
        try:
            # Check if file exists in AUDIO_DIR unless absolute path provided
            # The calling code often passes simple filenames like "SenderIntro.wav"
            # We assume the caller handles the path check or we try to reconstruct it
            # But the caller (Phone.play_async) constructs the path before passing strictly?
            # Actually, `Phone.play_async` creates the full path `f"{AUDIO_DIR}/{f}"` 
            # BUT then calls `self.audio.play(path, ...)`
            # Wait, `Phone.play_async` calls `self.audio.play` with the FULL PATH.
            
            with wave.open(str(filename), 'rb') as wf:
                print(f"Streaming {filename} to {self.name} (Serial)...")
                
                # Verify format (Should be 8-bit mono for simple Arduino streaming usually)
                width = wf.getsampwidth()
                channels = wf.getnchannels()
                
                if width != 1 or channels != 1:
                    print(f"WARNING: Serial streaming usually requires 8-bit Mono. Found: {width*8}-bit {channels}ch.")
                    # We might need to convert on the fly if strictly required, but for now we follow script.py logic
                    # script.py just reads frames and sends them.
                
                data = wf.readframes(self.chunk_size)
                
                while data:
                    if stop_event.is_set():
                        print(f"Stopping stream for {filename}...")
                        break

                    self.ser.write(data)
                    
                    # Prevent buffer overflow on Arduino side / give it time to process
                    # 8000Hz @ 64 samples = 8ms. Sleep slightly less than that.
                    time.sleep(0.005) 
                    
                    data = wf.readframes(self.chunk_size)
                    
        except Exception as e:
            print(f"Error streaming audio on {self.name}: {e}")
            
    # Record is not implemented for Serial in this scope
    
    def close(self):
        # We don't close the serial port here because it might be managed externally 
        # or we might want to keep it open. But typically we should.
        # script.py closes them at the end.
        pass

class Phone:
    """Represents a physical phone unit (T1 or T2)."""
    def __init__(self, number: str, audio_channel: AudioChannel):
        self.number = number     # "1" or "2"
        self.name = f"T{number}" # "T1" or "T2"
        self.audio = audio_channel
        
        self.state = PhoneState.IDLE
        self.dial_buffer = ""
        
        # Audio Threading
        self.stop_event = threading.Event()
        self.thread: Optional[threading.Thread] = None

    def set_state(self, new_state: str):
        print(f"Phone {self.number} State: {self.state} -> {new_state}")
        self.state = new_state

    def play_async(self, playlist: List[Union[str, Tuple[str, float]]]):
        """
        Play a list of files or pauses in a background thread.
        Playlist items can be: "filename.wav" OR ("PAUSE", duration_in_seconds)
        """
        self.stop_audio()
        self.stop_event.clear()
        
        def _play_sequence():
            for item in playlist:
                if self.stop_event.is_set():
                    break
                
                # Handle Tuple (e.g., PAUSE)
                if isinstance(item, tuple) and item[0] == "PAUSE":
                    duration = item[1]
                    print(f"Phone {self.number}: Pausing for {duration:.2f}s")
                    time.sleep(duration)
                    continue

                # TODO: SO HERE I CAN ADD DIALING TONES & WAITING TONES TO?
                # WAITING

                # Handle Filename
                f = item
                path = f"{AUDIO_DIR}/{f}"
                if Path(path).exists():
                    self.audio.play(path, self.stop_event)
                else: 
                     print(f"File not found or skipped: {path}")

        self.thread = threading.Thread(target=_play_sequence, daemon=True)
        self.thread.start()

    def record_async(self, filename: str):
        """Record audio in a background thread."""
        self.stop_audio()
        self.stop_event.clear()
        
        def _record_task():
            self.audio.record(filename, self.stop_event)
            
        self.thread = threading.Thread(target=_record_task, daemon=True)
        self.thread.start()

    def stop_audio(self):
        """Stops any currently playing or recording audio."""
        self.stop_event.set()
        if self.thread and self.thread.is_alive():
            self.thread.join(timeout=0.5)

    def get_duration(self, playlist: List[Union[str, Tuple[str, float]]]) -> float:
        """Calculates the total duration of a playlist (files + pauses)."""
        total_time = 0.0
        for item in playlist:
            if isinstance(item, tuple) and item[0] == "PAUSE":
                total_time += item[1]
                continue
                
            path = f"{AUDIO_DIR}/{item}"
            if Path(path).exists():
                try:
                    with wave.open(path, 'rb') as wf:
                        frames = wf.getnframes()
                        rate = wf.getframerate()
                        total_time += (frames / float(rate))
                except Exception as e:
                    print(f"Error getting duration for {item}: {e}")
        return total_time
        
    def has_sound(self, filename: str, threshold: int = 500) -> bool:
        """Checks if a recording has sound above a certain RMS threshold."""
        path = f"{AUDIO_DIR}/{filename}"
        if not Path(path).exists(): return False
        
        try:
             with wave.open(path, 'rb') as wf:
                 chunk_size = 1024
                 while True:
                     data = wf.readframes(chunk_size)
                     if not data: break
                     
                     count = len(data) // 2
                     if count == 0: continue
                     
                     shorts = struct.unpack(f"<{count}h", data)
                     sum_squares = sum(s**2 for s in shorts)
                     rms = math.sqrt(sum_squares / count)
                     
                     if rms > threshold:
                         return True
        except Exception as e:
             print(f"Error checking sound in {filename}: {e}")
        
        return False

#------------------------ SYSTEM LOGIC ------------------------#
class PhoneSystem:
    """Core Logic Controller for the Connection System."""
    
    def __init__(self, device_map: Dict[str, Any]):
        # Setup Phones
        self.t1 = Phone("1", device_map.get("T1"))
        self.t2 = Phone("2", device_map.get("T2"))
        self.phones = {"1": self.t1, "2": self.t2}
        
        # Serial Connection
        self.main_serial = device_map.get("MAIN")
        
        # System State
        self.mode = SystemMode.IDLE
        self.sender: Optional[Phone] = None
        self.receiver: Optional[Phone] = None
        
        # Dial Buffers
        self.dial_buffer = {"1": "", "2": ""}
        self.question = None
        
        # Timer Management
        self.timers: Dict[str, threading.Timer] = {}
        
        # Dynamic State Handler
        self.current_case_handler: Optional[Callable] = None

    # --- Utility Methods ---
    def start_timer(self, name: str, duration: float, callback: Callable):
        """Starts a named timer, cancelling any previous one with the same name."""
        self.stop_timer(name)

        timer = threading.Timer(duration, callback)
        self.timers[name] = timer
        timer.start()
        
    def stop_timer(self, name: str):
        """Stops/Cancels a named timer."""
        if name in self.timers:
            self.timers[name].cancel()
            del self.timers[name]

    def get_other_phone(self, phone: Phone) -> Phone:
        return self.t2 if phone == self.t1 else self.t1
    
    def reset_system(self):
        print("System Reset to IDLE")
        self.mode = SystemMode.IDLE
        self.sender = None
        self.receiver = None
        self.question = None
        
        # Stop all timers
        for name in list(self.timers.keys()):
            self.stop_timer(name)
            
        self.current_case_handler = None

    # --- Event Handlers ---
    def handle_event(self, action: Tuple[str, str, Any]):
        action_type, phone_num, extra_data = action
        phone = self.phones.get(phone_num)
        if not phone: return

        print(f"Event: {action_type} from Phone {phone_num} (Mode: {self.mode})")

        if action_type == "is_offHook":
            self.on_offhook(phone)
        elif action_type == "is_onHook":
            self.on_onhook(phone)
        elif action_type == "is_dialing":
            self.on_dial(phone, extra_data)

    def on_offhook(self, phone: Phone):
        if phone.state != PhoneState.IDLE: return
        phone.set_state(PhoneState.OFFHOOK)

        if self.mode == SystemMode.IDLE:
            self.run_case_conversation(phone)
        
        elif self.mode == SystemMode.CALL_SETUP:
            if self.current_case_handler:
                self.current_case_handler("is_offHook", phone)
        
        elif self.mode == SystemMode.VOICEMAIL and self.sender:
            self.run_sub_case_voicemail_interuption()

    def on_onhook(self, phone: Phone):
        phone.stop_audio()
        phone.set_state(PhoneState.IDLE)

        # send R1_CLOSE to arduino
        print("Sending R1_CLOSE to Arduino...")
        if self.main_serial:
            self.main_serial.write(b"R1_CLOSE\n")
        
        # Reset System if both phones are idle
        other = self.get_other_phone(phone)
        if other.state == PhoneState.IDLE:
            self.reset_system()

    def on_dial(self, phone: Phone, number: int):
        print(f"Phone {phone.number} dialed {number}")
        self.dial_buffer[phone.number] += str(number)
        
        if self.mode == SystemMode.CALL_SETUP:
             if self.current_case_handler:
                 self.current_case_handler("dial", phone)
        
        elif self.mode == SystemMode.VOICEMAIL_RECORDING:
             if self.current_case_handler:
                 self.current_case_handler("dial", phone)
                 
        elif self.mode == SystemMode.VOICEMAIL:
             if self.current_case_handler:
                 self.current_case_handler("dial", phone)

    # --- LOGIC FLOWS ---
    # 1. Main Conversation Flow
    def run_case_conversation(self, sender: Phone):
        print(f"--- STARTING CASE: CONVERSATION ---")
        self.mode = SystemMode.CALL_SETUP
        self.sender = sender
        self.receiver = self.get_other_phone(sender)
        
        self.run_sub_case_conversation_intro()

    def run_sub_case_conversation_intro(self):
        print(f"-> CONVERSATION INTRO")
        files = ["SenderIntro.wav"]
        self.sender.play_async(files)

        # Reset Buffer & Handler
        self.dial_buffer[self.sender.number] = ""
        self.current_case_handler = self.run_sub_case_conversation_dial
        
        # Start Reminder Loop
        duration = self.sender.get_duration(files)
        self.start_dial_reminder(extra_delay=duration)

        # Check for Early Receiver
        if self.receiver.state == PhoneState.OFFHOOK:
            print("Receiver is already OFFHOOK. Playing Wait Message.")
            self.receiver.play_async(["ReceiverOffhookBeforeRing.wav", "WAITING_TONE"])

    def start_dial_reminder(self, extra_delay: float = 0.0):
        # Starts a recursive 10s timer
        timeout = 10.0 + extra_delay
        self.start_timer("dial_reminder", timeout, self.on_dial_reminder_timeout)

    def on_dial_reminder_timeout(self):
        print("Dial Reminder Timeout! Playing Reminder...")
        if self.mode == SystemMode.CALL_SETUP and self.sender:
            audio_files = ["ReminderToDial.wav"]
            self.sender.play_async(audio_files)
            duration = self.sender.get_duration(audio_files)
            self.start_dial_reminder(extra_delay=duration)

    def run_sub_case_conversation_dial(self, event_type: str, phone: Phone, extra=None):        
        if event_type == "dial" and phone == self.sender:
            # Re-trigger timer to prevent timeout while dialing
            self.start_dial_reminder()
            
            current_input = self.dial_buffer[self.sender.number]
            print(f"Checking input for {self.sender.name}: {current_input}")
             
            if current_input == "0":
                # Valid start, wait for next digit
                return

            elif current_input.startswith("0") and len(current_input) > 1:
                # Valid Number
                print(f"Valid Number: {current_input}")
                self.question = current_input
                self.stop_timer("dial_reminder")
                
                if self.receiver.state == PhoneState.OFFHOOK:
                    print("Receiver Waiting -> Connect Immediately")
                    self.run_sub_case_conversation_starter()
                else:
                    self.run_sub_case_conversation_ring()
             
            else:
                # Invalid Start
                print("Wrong Number (Must start with 0)")
                self.sender.play_async(["WrongNumber.wav"])
                self.dial_buffer[self.sender.number] = ""
                # Reminder timer continues

        elif event_type == "is_offHook" and phone == self.receiver:
             print("Receiver picked up EARLY.")
             phone.play_async(["ReceiverOffhookBeforeRing.wav"])

        elif event_type == "offhook" and phone == self.receiver:
             # Should not happen as 'is_offHook' is primary event, but keeping safety
             self.run_sub_case_conversation_starter()

    def run_sub_case_conversation_ring(self):
        print(f"--- CONVERSATION RING ---")
        self.sender.play_async(["SenderDialedNumber.wav"])
        # Receiver ringing is handled by hardware usually, or we play audio?
        # Original code had comments: # receiver: play ring
        
        self.start_timer("ringing_timeout", 15.0, self.run_sub_case_conversation_ring_timeout)
        self.current_case_handler = self.run_sub_case_conversation_wait_answer

    def run_sub_case_conversation_wait_answer(self, event_type: str, phone: Phone, extra=None):
        if event_type == "is_offHook" and phone == self.receiver:
            self.stop_timer("ringing_timeout")
            self.run_sub_case_conversation_starter()

    def run_sub_case_conversation_starter(self):
        print(f"--- CONVERSATION STARTER ---")
        
        dialed_suffix = self.question
        topic = f"topic-{dialed_suffix}.wav"
        question = f"question-{dialed_suffix}.wav"

        # Define Audio Parts
        sender_part1 = ["SenderCall1.wav", topic, "SenderCall2.wav"]
        sender_part2 = ["SenderCall3.wav"]
        
        receiver_part1 = ["ReceiverCall1.wav"]
        receiver_part2 = ["ReceiverCall2.wav", topic, "ReceiverCall3.wav"]
        
        # Sync Calculation
        duration_s1 = self.sender.get_duration(sender_part1)
        duration_s2 = self.sender.get_duration(sender_part2)
        duration_r1 = self.receiver.get_duration(receiver_part1)
        duration_r2 = self.receiver.get_duration(receiver_part2)
        
        total_s = duration_s1 + duration_s2
        total_r = duration_r1 + duration_r2
        base_pause = 3.0
        
        if total_s < total_r:
            pause_sender = base_pause + (total_r - total_s)
            pause_receiver = base_pause
        else:
            pause_sender = base_pause
            pause_receiver = base_pause + (total_s - total_r)
            
        print(f"Syncing: Sender Pause={pause_sender:.2f}s, Receiver Pause={pause_receiver:.2f}s")

        sender_list = sender_part1 + [("PAUSE", pause_sender)] + sender_part2
        receiver_list = receiver_part1 + [("PAUSE", pause_receiver)] + receiver_part2
        
        self.sender.play_async(sender_list)
        self.receiver.play_async(receiver_list)
        
        max_duration = max(total_s + pause_sender, total_r + pause_receiver)
        
        # Schedule "Together" part
        self.start_timer("together_part", max_duration + 0.5, lambda: self.run_sub_case_conversation_together(question))

    def run_sub_case_conversation_together(self, question: str):
        print("--- CONVERSATION TOGETHER PART ---")
        print("Sending R1_OPEN to Arduino...")
        if self.main_serial:
            self.main_serial.write(b"R1_OPEN\n")

        common = [question, "SenderReceiverCall4.wav"]
        self.sender.play_async(common)
        self.receiver.play_async(common)

    # 2. Voicemail Flow
    def run_sub_case_conversation_ring_timeout(self):
        print("--- CONVERSATION RING TIMEOUT (VOICEMAIL) ---")
        self.mode = SystemMode.VOICEMAIL
        
        dialed_suffix = self.question
        if len(dialed_suffix) < 2: dialed_suffix = "01"
        
        vm_playback_file = f"voicemail-{self.sender.name}-{dialed_suffix}.wav"
        
        files = [
            "SenderVoiceMail1.wav",  # Intro
            vm_playback_file,        # "voicemail-T1-01.wav"
            "SenderVoiceMail4.wav"   # "Leave a message..."
        ]
        
        print(f"Playing Voicemail Sequence on {self.sender.name}...")
        self.sender.play_async(files)
        
        duration = self.sender.get_duration(files)
        self.start_timer("voicemail_start", duration + 0.5, self.run_sub_case_voicemail_record)

    def run_sub_case_voicemail_record(self):
        print("--- VOICEMAIL RECORDING START ---")
        self.sender.set_state(PhoneState.VOICEMAIL_RECORDING)
        self.mode = SystemMode.VOICEMAIL_RECORDING
        
        self.temp_filename = f"temp_recording.wav"
        self.sender.record_async(self.temp_filename)
        
        # Max Recording Loop
        self.start_timer("recording_limit", 20.0, self.on_recording_timeout)
        self.current_case_handler = self.run_sub_case_voicemail_record_wait

    def run_sub_case_voicemail_record_wait(self, event_type: str, phone: Phone, extra=None):
        if event_type == "dial" and phone == self.sender:
            print("User stopped recording (Dialed)")
            self.stop_recording()
            self.run_sub_case_voicemail_end()

        elif event_type == "is_offHook" and phone == self.receiver:
            print("Interruption during recording!")
            self.stop_recording()
            self.run_sub_case_voicemail_interuption()

    def on_recording_timeout(self):
        print("Recording Timeout!")
        self.stop_recording()
        self.run_sub_case_voicemail_end()

    def stop_recording(self):
        self.stop_timer("recording_limit")
        self.sender.set_state(PhoneState.OFFHOOK)

    def run_sub_case_voicemail_end(self):
        print("--- VOICEMAIL END ---")
        self.sender.play_async(["SenderVoiceMailEnd.wav"])
        
        # Validate Recording
        final_filename = f"voicemail-{self.sender.name}-{self.question}.wav"
        try:
             duration = self.sender.get_duration([self.temp_filename])
             has_audio = self.sender.has_sound(self.temp_filename)
             
             if duration > 1.0 and has_audio:
                 print(f"Recording VALID. Saving to {final_filename}")
                 src = f"{AUDIO_DIR}/{self.temp_filename}"
                 dst = f"{AUDIO_DIR}/{final_filename}"
                 if os.path.exists(src):
                     shutil.move(src, dst)
             else:
                 print("Recording INVALID. Discarding.")
                 src = f"{AUDIO_DIR}/{self.temp_filename}"
                 if os.path.exists(src):
                     os.remove(src)
        except Exception as e:
             print(f"Error validating recording: {e}")

    # 3. Interruption Flow
    def run_sub_case_voicemail_interuption(self):
        print("--- VOICEMAIL INTERUPTION ---")
        self.previous_mode = self.mode
        
        # Stop pending voicemail/recording timers
        self.stop_timer("recording_limit")
        self.stop_timer("voicemail_start")
            
        self.sender.stop_audio()
        self.receiver.stop_audio()
        
        # Reset Sender Buffer for choice
        self.dial_buffer[self.sender.number] = ""
        
        print("Sender: dial 1 to Connect, 2 to Refuse")
        self.sender.play_async(["SenderVoicemailIncomingCall.wav"])
        
        self.current_case_handler = self.run_sub_case_voicemail_interuption_choice

    def run_sub_case_voicemail_interuption_choice(self, event_type: str, phone: Phone, extra=None):
        if event_type == "dial" and phone == self.sender:
             choice = self.dial_buffer[self.sender.number]
             print(f"Interruption Choice: {choice}")
             
             if choice == "1":
                 print("Choice 1: Connect")
                 self.sender.play_async(["SenderRecieverVoicemailCall.wav"])
                 self.run_sub_case_conversation_starter()
                 
             elif choice == "2":
                 print("Choice 2: Refuse")
                 self.sender.play_async(["SenderVoicemailRefusedCall.wav"])
                 self.run_sub_case_voicemail_refuse()
                 
             elif len(choice) > 1:
                 # Reset if invalid
                 self.dial_buffer[self.sender.number] = ""

    def run_sub_case_voicemail_refuse(self):
        print("--- VOICEMAIL REFUSE ---")
        self.receiver.play_async(["ReceiverVoicemailRefusedCall.wav"])
        self.receiver.set_state(PhoneState.IDLE)
        
        files = ["SenderVoicemailRefusedCall.wav"]
        duration = self.sender.get_duration(files)
        
        self.start_timer("resume_vm", duration + 0.5, self.run_sub_case_voicemail_resume)

    def run_sub_case_voicemail_resume(self):
        print("--- RESUMING VOICEMAIL ---")
        # Resume based on previous state
        if self.previous_mode == SystemMode.VOICEMAIL_RECORDING:
            print("Restarting Recording Phase")
            self.run_sub_case_voicemail_record()
        else:
            print("Restarting Voicemail Sequence")
            self.run_sub_case_conversation_ring_timeout()

#------------------------ HELPERS & MAIN ------------------------#

def find_arduinos() -> Dict[str, Any]:
    print("Searching for Serial Devices...")
    ports = list(serial.tools.list_ports.comports())
    real_arduino = None
    t1_arduino = None
    t2_arduino = None
    
    if ports:
        print(f"Found {len(ports)} ports:")
        for p in ports:
            print(f" - {p.device}: {p.description}")
            # Heuristic check
            if any(k in p.description for k in ["Arduino", "USB Serial", "usbmodem"]):
                try:
                    ser = serial.Serial(p.device, DEFAULT_BAUDRATE, timeout=2)
                    time.sleep(2)
                    
                    print(f"Handshake with {p.device}...")
                    ser.reset_input_buffer()
                    ser.write(b"IDENTIFY\n")
                    
                    identifier = ser.readline().decode('utf-8').strip()
                    print(f"Response: {identifier}")
                    
                    if identifier == "MAIN":
                        print(f"Verified MAIN Arduino on {p.device}")
                        real_arduino = ser
                        # Consume initial state lines
                        while ser.in_waiting:
                             print(f"Init: {ser.readline().decode('utf-8').strip()}")
                    elif identifier == "T1":
                        print(f"Verified T1 Arduino on {p.device}")
                        t1_arduino = ser
                    elif identifier == "T2":
                        print(f"Verified T2 Arduino on {p.device}")
                        t2_arduino = ser
                    else:
                        ser.close()
                except Exception as e:
                    print(f"Connection failed {p.device}: {e}")
                    if 'ser' in locals() and ser.is_open:
                        ser.close()

    # Create Audio Channels based on connection
    if t1_arduino:
        print("T1 Connected via Serial -> Using SerialAudioChannel")
        t1_channel = SerialAudioChannel("T1", t1_arduino)
    else:
        print("T1 NOT Connected -> Using LocalAudioChannel (Left)")
        t1_channel = LocalAudioChannel("T1", "left")

    if t2_arduino:
        print("T2 Connected via Serial -> Using SerialAudioChannel")
        t2_channel = SerialAudioChannel("T2", t2_arduino)
    else:
        print("T2 NOT Connected -> Using LocalAudioChannel (Right)")
        t2_channel = LocalAudioChannel("T2", "right")

    device_map = {
        "T1": t1_channel,
        "T2": t2_channel
    }

    if real_arduino:
        device_map["MAIN"] = real_arduino
    else:
        print("WARNING: No real MAIN Arduino found. Using TERMINAL INPUT.")
        device_map["MAIN"] = TerminalAdapter()
        
    return device_map

def parse_action(line: str) -> Optional[Tuple[str, str, Any]]:
    # Patterns: "T1_OFFH", "T2_ONH", "T1_N5"
    patterns = {
        "is_offHook": r"T(\d+)_?OFFH",
        "is_onHook": r"T(\d+)_?ONH",
        "is_dialing": r"T(\d+)_?N(\d+)"
    }
    for action_name, pattern in patterns.items():
        if match := re.match(pattern, line):
            groups = match.groups()
            # If dialing, return (action, phone, number_int)
            # If hook, return (action, phone, None)
            val = int(groups[1]) if action_name == "is_dialing" else None
            return (action_name, groups[0], val)
    return None

def main():
    print("Initializing System...")
    
    # Setup Devices
    devices = find_arduinos()
    main_serial = devices.get("MAIN")
    
    if not main_serial:
        print("CRITICAL ERROR: No Input Device (Arduino/Terminal).")
        return

    # Setup System
    phone_system = PhoneSystem(devices)
    print("System Ready. Listening...")

    try:
        while True:
            # Check for input
            if main_serial.in_waiting > 0:
                try:
                    line_bytes = main_serial.readline()
                    line = line_bytes.decode('utf-8').strip()
                    
                    if action := parse_action(line):
                        phone_system.handle_event(action)
                    elif line:
                        print(f"Unknown Line: {line}")
                        pass
                        
                except Exception as e:
                    print(f"Input Error: {e}")
            else:
                time.sleep(0.01)

    except KeyboardInterrupt:
        print("\nExiting...")
    finally:
        print("Closing resources...")
        for name, dev in devices.items():
             if hasattr(dev, 'close'):
                 dev.close()

if __name__ == "__main__":
    main()
