Jana-Elst/passionProject/(commit log)

2026-01-10 redesign homepage with new hero section, blog post listing, and reusable button components.
2026-01-11 Implement blog post navigation with next/previous and back buttons, refactoring the post layout and updating the button component.
2026-01-13 added a arduino script, changed the readme file, changed typo in blog
2026-01-16 did some arduino tests
2026-01-20 switched pin
2026-01-22 added correct serial logs for pi
    [20260122-proMicro.ino]
2026-01-23 add sound function to arduino scripts
2026-01-23 changed wrong fromat of dialing
    [script.py]
2026-01-23 add resetting of arduino by setup
    [script.py]
2026-01-23 replaced sounds to right bitrate
    [script.py]
2026-01-23 removed timer & used 0 as a reset
    [script.py]
2026-01-24 changed sample rate
2026-01-24 changed sample rate to something very lowwww
2026-01-24 prev sound: low scrhhhhh, now connected pin A1 to gnd
2026-01-25 new circuit test
2026-01-25 add reset of dialed number if back onhook
    [script.py]
2026-01-25 add reset of dialed number
    [script.py]
2026-01-27 added R1 arduino communication
2026-01-27 add Raspberry Pi script for soundcards
2026-01-29 added new relays to test relays / changed on/off hook values for the phone. / changed comment for conversion
2026-02-04 basic logic with correct sound files is working
    [script.py]
2026-02-05 restructure part of the code. And conversation flow is working
2026-02-06 added handshake back to the arduino file
2026-02-06 fixed relais problem R1
    [20260112-1-testRelays.ino, arduino.ino]
2026-02-06 werkt het nu?
2026-02-07 added debounce, to ignore the fake onhook during relay switch
2026-02-07 remove debounce in script, add it to the arduino
2026-02-07 found the issue almost! The arduino was giving fake onhook states
    [arduino.ino, script.py]
2026-02-08 changed switch state mistake during ghost ring
    [script.py]
2026-08-24 ghost ring is fixed
    [script.py]
