Jana-Elst/passionProject/blog/src/assets/pictures/20260202-header.png

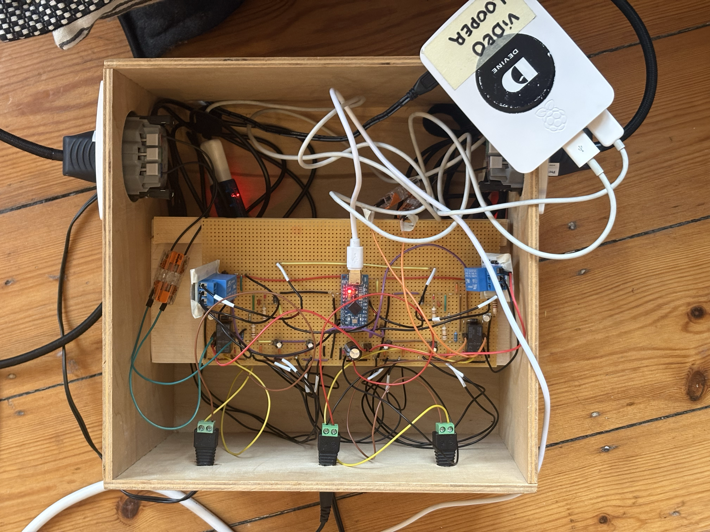
blog/src/assets/pictures/20260202-header.png
