Jana-Elst/passionProject/blog/src/assets/pictures/20260202-cable.png

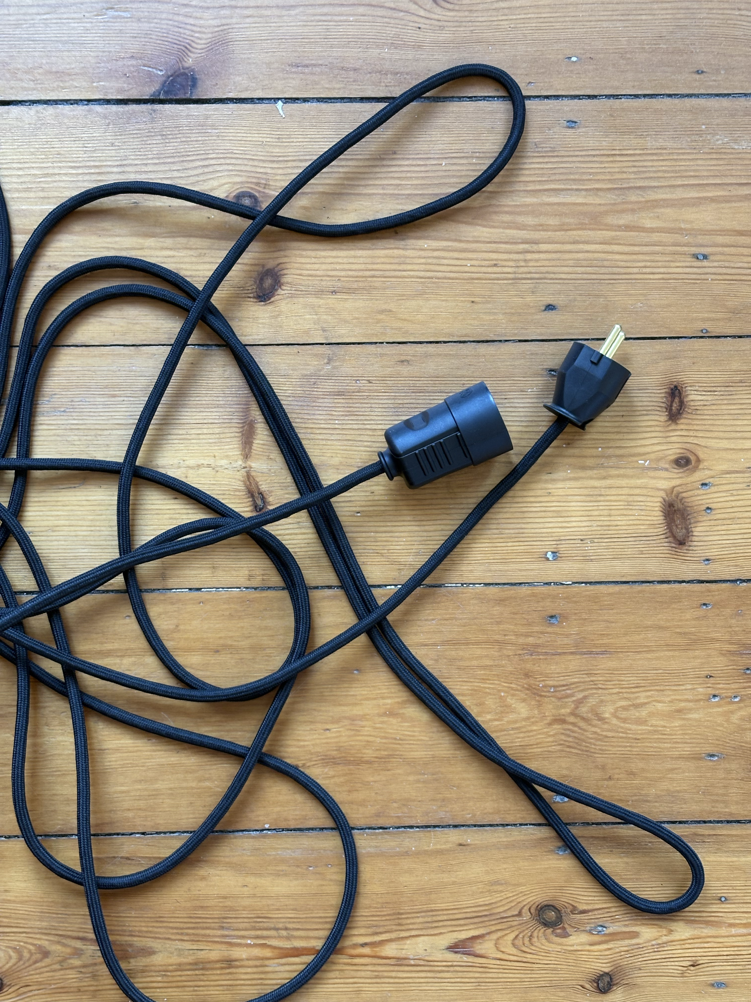
[picture p84: blog/src/assets/pictures/20260202-cable.png]
blog/src/assets/pictures/20260202-cable.png
